matgomes21/percepcao-termica/Hardware/PCB/CONTROLLER_02.png

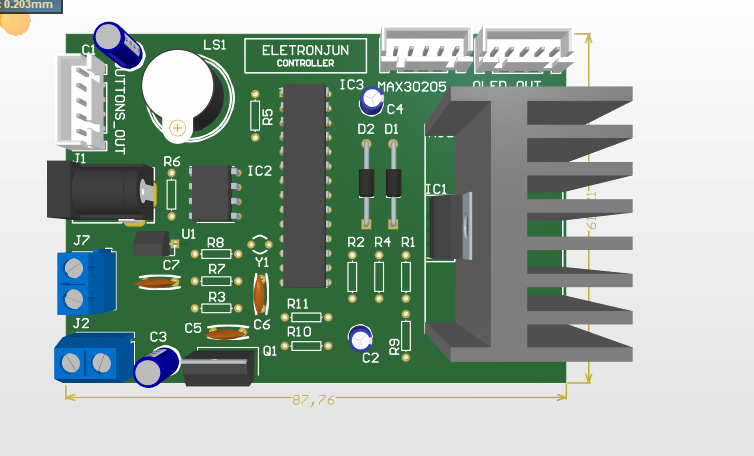
Hardware/PCB/CONTROLLER_02.png
