matgomes21/percepcao-termica/README.md

# Percepção Térmica

Projeto desenvolvido pela equipe Eletronjun, consiste na construção de um sistema de controle e coleta de temperatura corporal para monitoramento médico da sensibilidade epitelial.
