matgomes21/percepcao-termica/Documentation/Relatório_Técnico_Final.pdf

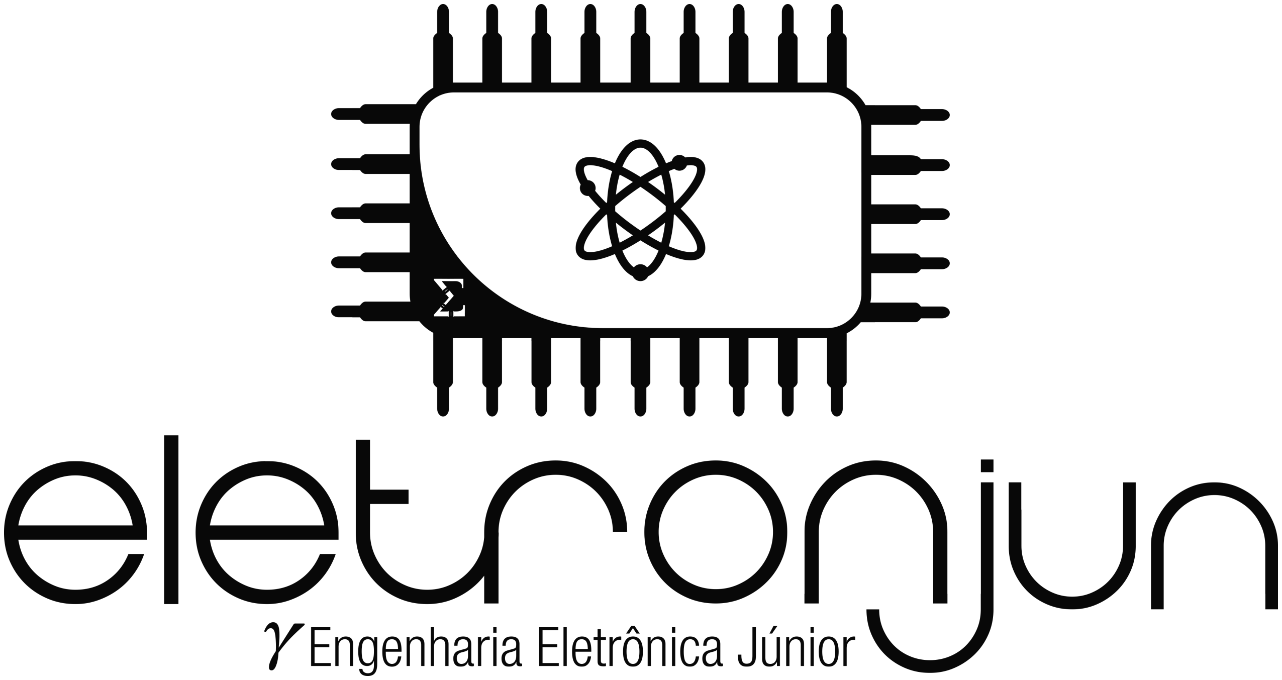
[picture p2: figure]

Percepçao T ˜ | ermica ´
Membros responsaveis: ´ | Amanda Henriques, Bruna Medeiros, Gustavo Linhares,
| Mateus Gomes, Matheus Gois, Natalia Ferreira e Vitor Guedes ´
Data de Início: | [21/10/2019]
Data de Entrega: | [22/08/2020]

2 HARDWARE

## 1 Introduçaõ

O projeto Percepçao t ˜ | ermica consiste na construç ´ | ao de um sistema de controle e ˜
coleta de temperatura corporal para monitoramento medico da sensibilidade epitelial. ´

Com os quatro subsistemas que constituem o projeto (controle e leitura de tem-
peratura, alimentaçao, interface gr ˜ | afica), o prot ´ | otipo ser ´ | a capaz de aumentar a tem- ´
peratura na pele enquanto a monitora. Ao atingir uma temperatura ”quente”, ou seja,
temperatura na qual o paciente sente essa sensaçao, o bot ˜ | aõ e apertado e os valores ´
sao armazenados e expostos no display. Dessa forma, o profissional de sa ˜ | ude ser ´ | á
capaz de avaliar a situaçao do usu ˜ | ario de forma eficiente. ´

Este documento tem como objetivo listar todos os componentes relacionados ao hardware, software e modelagem do sistema para o desenvolvimento do projeto, bem
como sua integraçao e funcionamento. Finalizando, assim, a fase de prototipaç ˜ | aõ
transcorrida ate aqui. ´

## 2 Hardware

### 2.1 Sensor MAX30205

O sensor de temperatura MAX30205 mede com precisao temperatura e fornece ˜ um alarme de superaquecimento / saída de interrupçao / desligamento. Este disposi- ˜ tivo converte as mediçoes de temperatura para o formato digital usando um conversor ˜
analogico-digital (ADC) de alta resoluç ´ | ao, sigma-delta. ˜
A precisao atende ˜ | as especificaç ` | oes cl ˜ | ínicas de termometria de o ASTM E1112
quando soldado na PCB final. Neste projeto, o mesmo sera aplicado na palma da ´
mao, antebraço, peito p ˜ | e e coxa. ´

ELETRONJUN – UNIVERSIDADE DE BRASÍLIA
EMPRESA JUNIOR DE ENGENHARIA ELETR ´ | ONICA ˆ
Area Especial de Ind ´ | ustria ´ | − Projeçao A ˜ | | 72444-240 | Gama/DF
www.eletronjun.com.br | contato@eletronjun.com.br

2.1.1 Especificaçoes T ˜ | ecnicas ´
Tensao de operaç ˜ | aõ | 2,7 a 3,3 V
Corrente de operaçaõ | 600µA
Tipo de comunicaçaõ | I2C
Precisaõ | | 0.1 ◦C

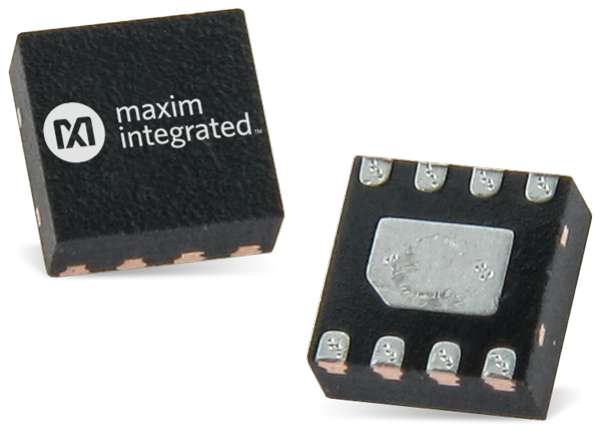
[picture p3: figure]

### 2.2 OLED

O Display OLED com tela de 0,96 conta com tecnologia que o possibilita ter uma
iluminaçao pr ˜ | opria, n ´ | ao sendo necess ˜ | aria a utilizaç ´ | ao de ˜ | backlight, intensificando o
contraste no conteudo exibido e consecutivamente apresentando maior economia de ´ energia.
Por ja estar integrado em um m ´ | odulo e possuir comunicaç ´ | ao I2C, o Display OLED ˜
e ideal para aplicaç ´ | ao em projetos de prototipagem baseados em microcontroladores, ˜
entre eles, o Arduino, possuindo pinagem fixa para alimentaçao e entrada de dados ˜ I2C.
2.2.1 Especificaçoes T ˜ | ecnicas ´
Tensao de operaç ˜ | aõ | 3,3 a 5V
Corrente de operaçaõ | 24mA
Tipo de comunicaçaõ | I2C
Preço Unitario ´ | | R$ 33,90

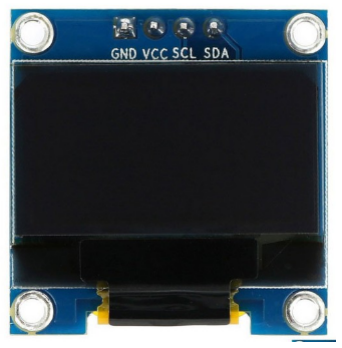
[picture p4: figure]

### 2.3 LED RGB

O LED (light-emitting diode) RGB, como o proprio nome indica, ´ | e um led capaz ´
de gerar 3 cores: vermelho ((R) red), verde ((G) green) e azul ((B) blue). Esse com-
ponente se torna muito util quando precisamos de uma indicaç ´ | ao visual do que est ˜ | á
acontecendo com o nosso sistema. Alem dessas 3 cores, ligando 2 ou 3 delas si- ´ multaneamente, podemos gerar as cores de sua combinaçao, aumentando assim o ˜

numero de possibilidades que podemos representar. ´

2.3.1 Especificaçoes T ˜ | ecnicas ´
Tensoes de operaç ˜ | aõ

2.0 V (Vermelho)
3.4 V (Verde)
3.4 V (Azul)
Corrente de operaçaõ | 20mA
Preço Unitario ´ | R$ 0,95

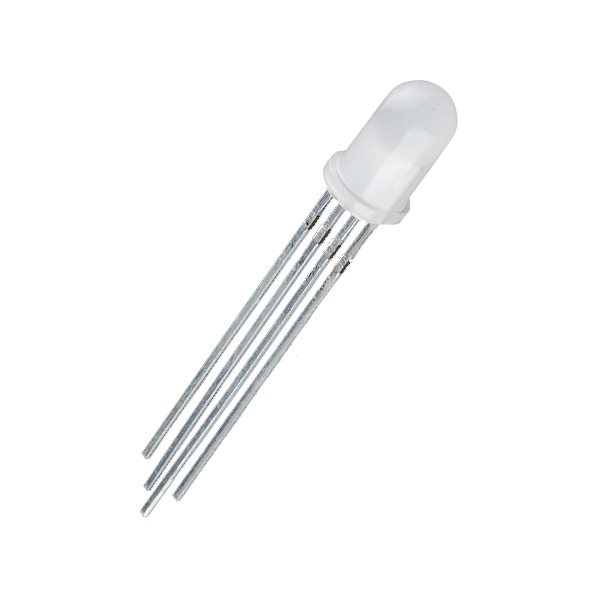
[picture p5: figure]

### 2.4 Botoes ˜

Os botoes s ˜ | ao componentes simples, por ˜ | em muito bem utilizados em diversas ´
aplicaçoes do nosso dia-a-dia: usando um controle remoto, acessando sites pela in- ˜ ternet, utilizando um micro-ondas etc. Esse pequeno componente possui um princípio bem simples de funcionamento, permitindo ou nao a passagem de corrente. Com ˜
isso, quando apertamos ou soltamos um botao, fazemos com que alguma operaç ˜ | aõ
dentro do sistema ocorra, gerando assim o resultado que desejamos.

### 2.4.1 Especificaçoes T ˜ ecnicas ´

Chave Tactil ´

Tensao de operaç ˜ | aõ | XX
Corrente de operaçaõ | 50mA
Preço Unitario ´ | | R$ 0,15

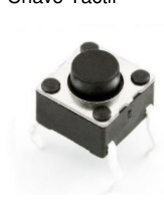
[picture p6: figure]
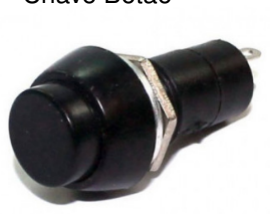
[picture p7: figure]

Chave Botaõ

Tensao de operaç ˜ | aõ | XX
Corrente de operaçaõ | 3A - 250VCA
Preço Unitario ´ | | R$ 1,80

### 2.5 Potenciometro Digital X9C104

Um potenciometro ˆ | e um componente capaz de variar sua resist ´ | encia. O mais ˆ
comumente usado e o potenci ´ | ometro anal ˆ | ogico, no qual possu ´ | ímos um eixo que,
quando girado, gera um aumento ou uma reduçao da resist ˜ | encia resultante. No caso ˆ
do projeto, esta sendo utilizado um potenci ´ | | ometro digital, ou seja, ao inv ˆ | es de girar- ´
mos o eixo do componente, nos conectamos os terminais do mesmo em um micro- ´ controlador e, utilizando suas portas de entrada e saída e um pouco de programaçao, ˜
nos controlamos essa resist ´ | encia sem precisar fazer qualquer alteraç ˆ | ao no circuito. ˜
Tensao de operaç ˜ | aõ | 5V
Corrente de operaçaõ | 3mA
Resistencia M ˆ | axima: ´ | 100 KΩ
Preço Unitario ´ | | $6.35

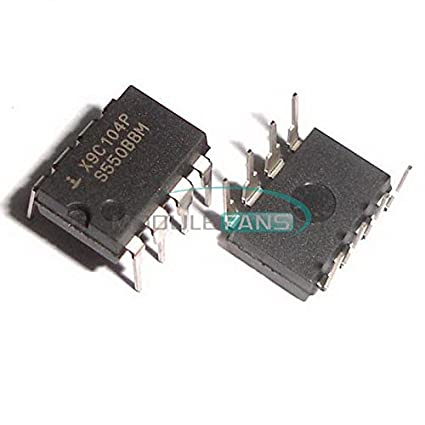
[picture p8: figure]

### 2.6 Reguladores

Um regulador de tensaõ e um componente capaz de realizar a manutenç ´ | ao da ˜
tensao de sa ˜ | ída de um circuito. Geralmente ele e utilizado na entrada de circuitos, ´
dentro de um sistema de controle de alimentaçao, com o objetivo principal de limi- ˜
tar sua tensao que passa por ele, evitando assim que passem tens ˜ | oes muito altas, ˜
capazes de danificar ou inutilizar um componente e/ou um circuito inteiro. Sendo as-
sim, sua utilidade esta intimamente atrelada ´ | a faixa de tens ` | ao em que ele consegue ˜
operar.

### 2.6.1 LM317

Maxima diferença entre ´
tensao de entrada e sa ˜ | ída

40V

Tensao de sa ˜ | ída | 1,2V a 37V
Corrente de saída | 1,5A
Preço Unitario ´ | | R$1,42

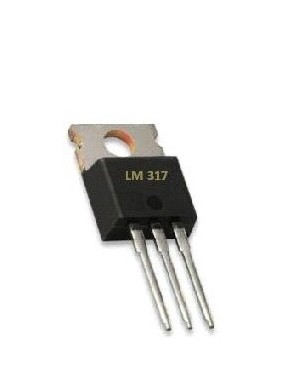
[picture p9: figure]

### 2.6.2 LM7805

Mínima diferença entre
tensao de entrada e sa ˜ | ída | 2,4V
Tensao de entrada ˜ | | 7,4 a 28V
Tensao de sa ˜ | ída | 5V
Corrente maxima de sa ´ | ída | 1,5A
Preço Unitario ´ | | R$0,99

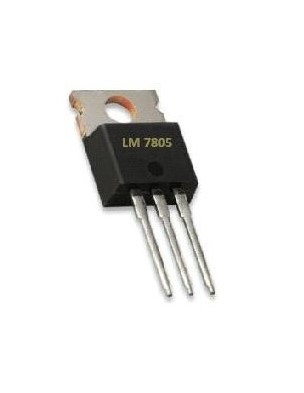
[picture p10: figure]

### 2.7 Peltier

O Peltier e uma pastilha termoel ´ | etrica que, atrav ´ | es de alimentaç ´ | ao controlada e ˜
adequada, possui a capacidade de aquecer e resfriar sua superfície em questao de ˜ alguns segundos ou minutos, a depender da alimentaçao. ˜
Ao colocar tensao nos terminais do Peltier, um lado ir ˜ | a aquecer rapidamente, en- ´
quanto o outro resfriara. Ao inverter a polaridade de ligaç ´ | ao, a Pastilha ir ˜ | a efetuar ´
o processo contrario, entrando em estado de aquecimento. Desse modo, torna-se ´ possível uma vasta aplicaçao em projetos com arduino e microcontroladores no ge- ˜ ral, como por exemplo: Coolers de CPU, mini-refrigeradores ou bebedouros e até aquecedores de agua. ´

Nome tecnico ´ | | TEC1-12709
Faixa de temperatura | -30 a 70o C
Tensao de operaç ˜ | aõ | 0 a 15V
Preço Unitario ´ | | R$29,90

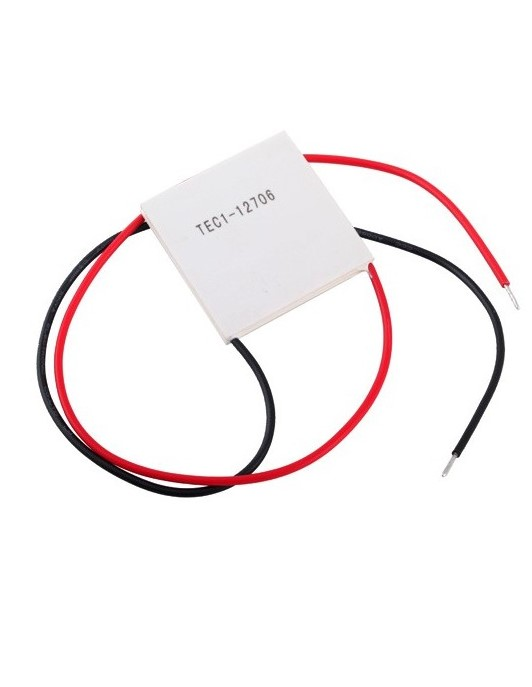
[picture p11: figure]

### 2.8 ATMega328P

O ATMega328P e um microprocessador extremamente comum em projetos eletr ´ | onicos. ˆ
Ele faz parte da família de microprocessadores ATMega, que e amplamente utilizada ´
em diversos microcontroladores do Arduino, que e muito conhecido para aplicaç ´ | oes ˜
simples e praticas dentro da eletr ´ | onica. O ATMega328P, em espec ˜ | ífico, e utilizado no ´
Arduino Uno R3, que e o modelo ”padr ´ | ao”da marca. Com ele temos portas dedicadas ˜
a comunicaçao I2C e UART, portas de entrada e sa ˜ | ída analogica e digital, possibi- ´
lidade de comunicaçaõ OneWire, comunicaçao com cart ˜ | ao SD, clock de 16MHz e ˜
muito mais.
Memoria ´ | | 32Kb
Resoluçao do conversor AD/DA ˜ | | 10 Bits
Tensao de Operaç ˜ | aõ | 1.8V a 5.5V
Preço Unitario ´ | | R$20,66

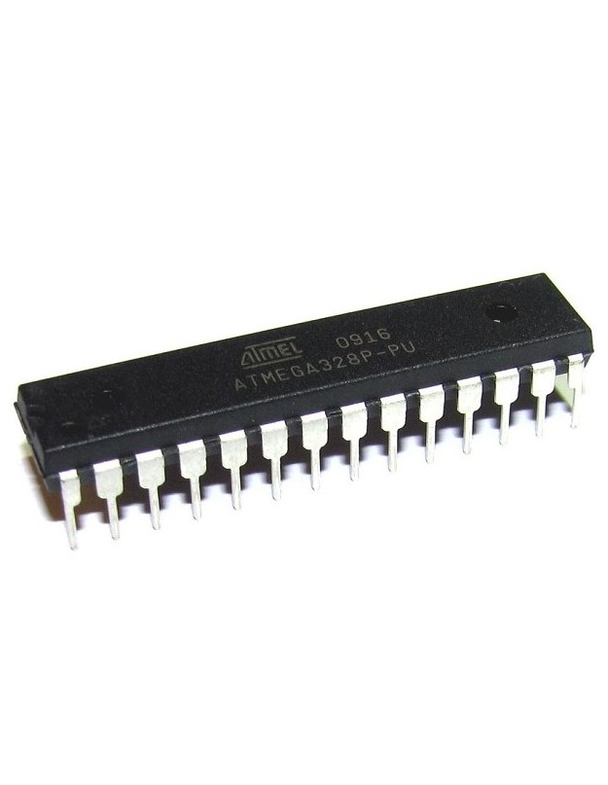
[picture p12: figure]

### 2.9 Buzzer

O Buzzer e um componente capaz de gerar um sinal sonoro. Seu ”volume”depende ´
da tensao em que opera. Alguns tipos de buzzer tamb ˜ | em possuem a ferramenta de ´
alteraçao de frequ ˜ | encia, possibilitando o ajuste dessa caracter ˆ | ísticas para a produçaõ
de musicas ou bips simples como aqueles de alarmes de carro, por exemplo. ´

Tensao de operaç ˜ | aõ | 5V
Corrente maxima ´ | | 42mA
Intensidade de saída | ≥ 85dB
Preço Unitario ´ | | R$1,52

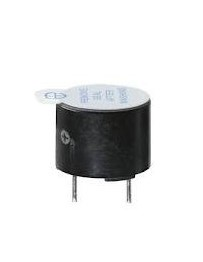
[picture p13: figure]

### 2.10 Mosfet IRF540n

Um transistor MOSFET(Metal Oxide Semiconductor Field Effect Transistor) e um ´ componente de 3 terminais que possui diversas aplicaçoes dentro do mundo de cir- ˜
cuitos eletronicos e afins. Um uso comum para esse tipo de componente ˆ | e utiliz ´ | a-lo ´
como uma chave, fazendo-o ”desligar”em alguma situaçao espec ˜ | ífica. No nosso caso,
nos utilizamos essa funcionalidade para evitar gastos desnecess ´ | arios com n ´ | íveis de
tensao e corrente muitos baixos, que n ˜ | ao chegam nem a fazer nosso sistema funcio- ˜
nar totalmente. Com isso, e poss ´ | ível evitar o aquecimento dos componentes e gastos
de energia desnecessarios. ´

Corrente maxima no dreno (a 25 ´

oC) | 33 A
Dissipaçao m ˜ | axima de pot ´ | encia ˆ | 130W
VGS maximo ´ | | | ± 20V
Preço Unitario ´ | | | R$3,23

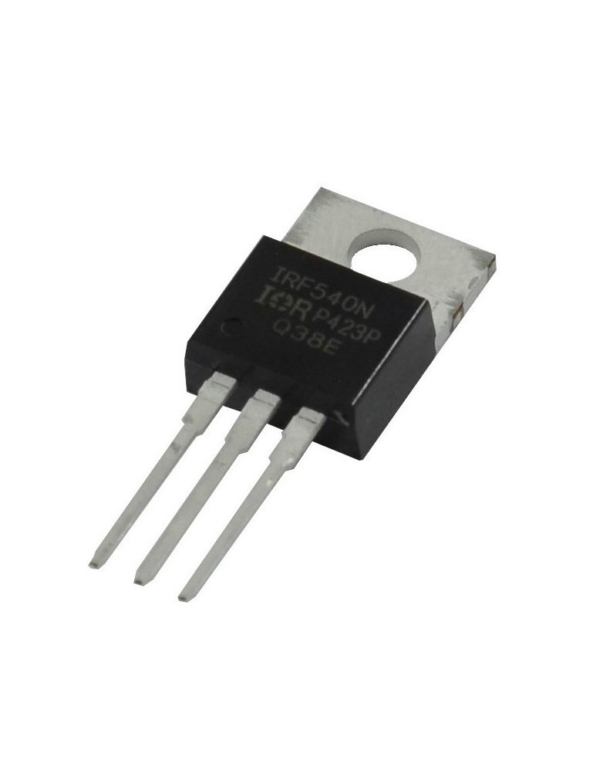
[picture p14: figure]

### 2.11 Integraçaõ

A etapa de integraçao do projeto ˜ | e onde juntamos todos os m ´ | odulos, componen- ´
tes, CIs (circuitos integrados) e tudo que compoe o circuito e o sistema do projeto no ˜
geral. O objetivo final dessa integraçaõ e fazer com que todos os m ´ | odulos do projeto, ´
que foram previamente testados e tidos como funcionais, continuem funcionando corretamente, sem qualquer tipo de defeito ou erro inesperado causado pela uniao do ˜ sistema.

### 2.11.1 Esquematico ´

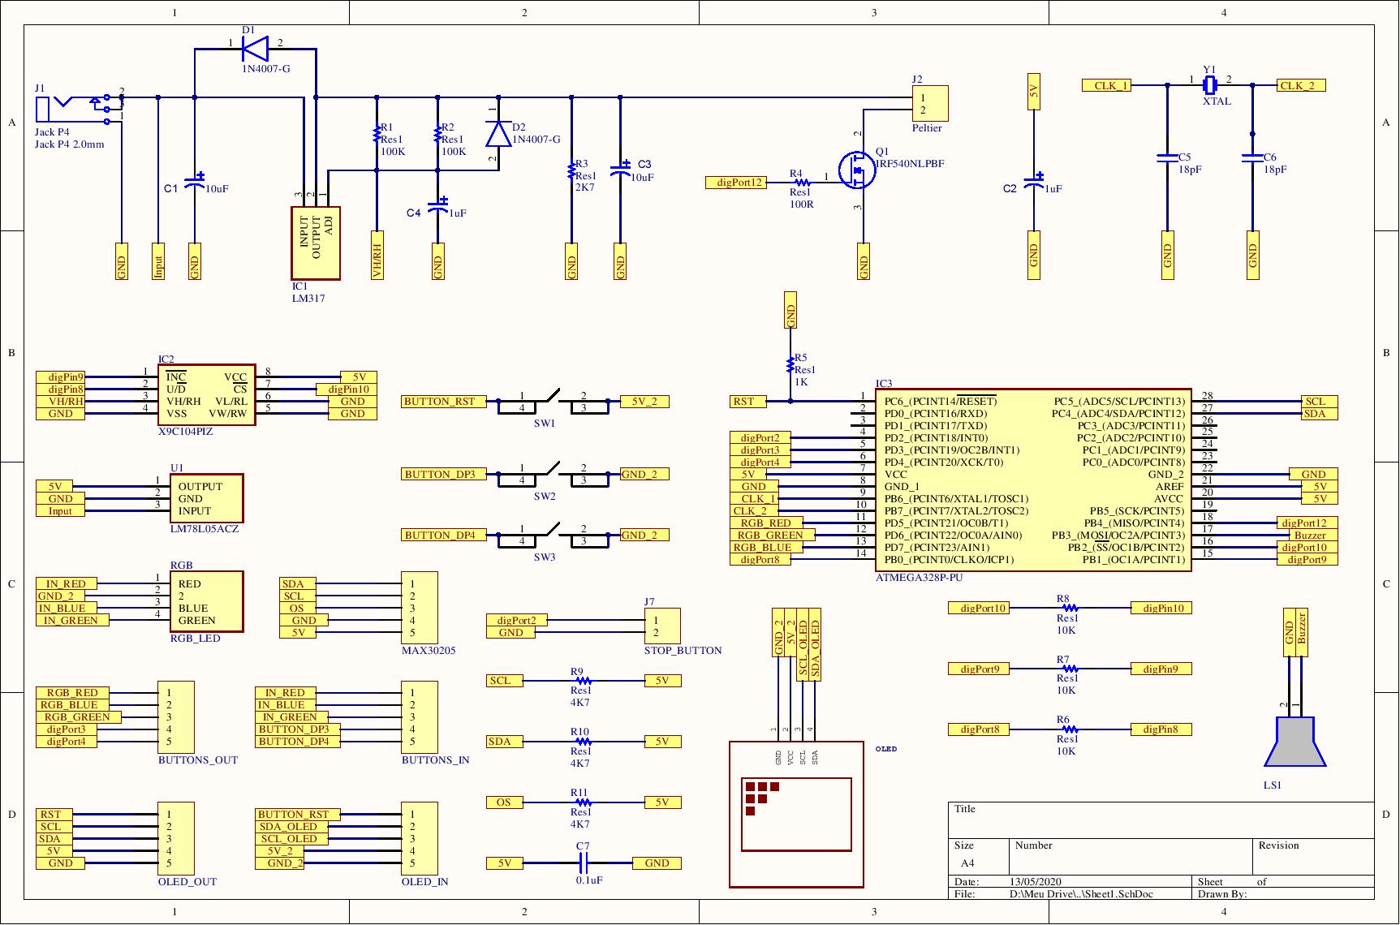
[picture p15: figure]

### 2.11.2 Layout PCI

PCI (placa de circuito impresso) ou, do ingles, PCB ( ˆ | Printed Circuit Board) e a ´
placa física em que contruímos nosso circuito. Utilizando o esquematico como um ´ guia de como devemos ligar cada componente, realizamos o processo de layout (”desenho”da PCI, realizado por meio de softwares no computador); de fabricaçao, onde ˜
sao feitas as trilhas e os furos do circuito, onde ser ˜ | ao colocados os componentes du- ˜
rante a etapa de soldagem. Com isso, temos uma PCB/PCI completa e pronta para uso.

Placa de Interface Nesse placa estao presentes todos os componentes com os ˜
quais o usuario do sistema dever ´ | a interagir ou que dever ´ | ao ser vistos por ele para ˜
indicar algo sobre o circuito: LEDs (o LED RGB, no caso), OLED e botoes. ˜

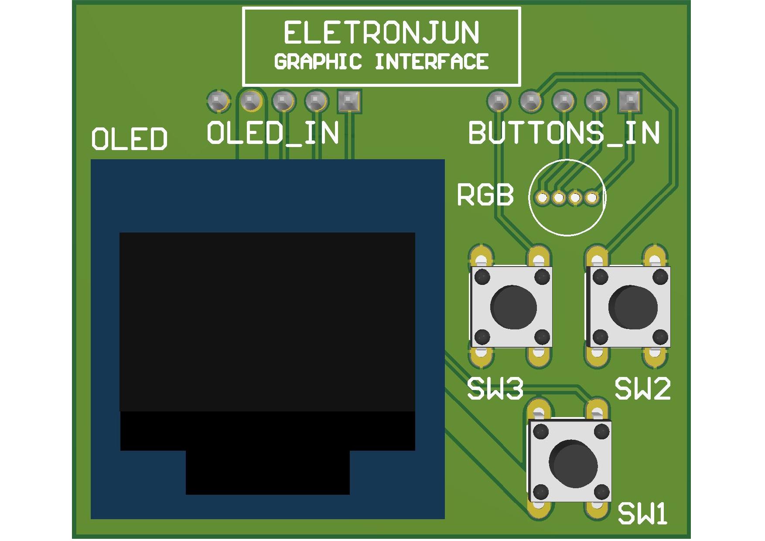
[picture p16: figure]

Placa de Controle Na placa de controle se encontram todos os demais componen-
tes do circuito: aqueles responsaveis pelo circuito de alimentaç ´ | ao, pelo circuito de ˜
controle de tensao e corrente, pela interface com software e outros. Nessa placa se ˜
encontra presente tambem o dissipador ( ´ | heatsink na imagem), que e utilizado para ´
reduzir a temperatura do LM317, que pode chegar a temperaturas de ate 125 ´

o C.

Alem disso, o ´ | buzzer, responsavel pelos avisos sonoros dentro do sistema, tamb ´ | em´
esta na placa de controle. Visto que o mesmo n ´ | ao necessita ser visto pelo usu ˜ | ario ´
para que funcione e que sua potencia sonora ˆ | e capaz de ser ouvida mesmo quando ´
isolado, nao foi necess ˜ | ario coloc ´ | a-lo na placa de interface gr ´ | afica. ´

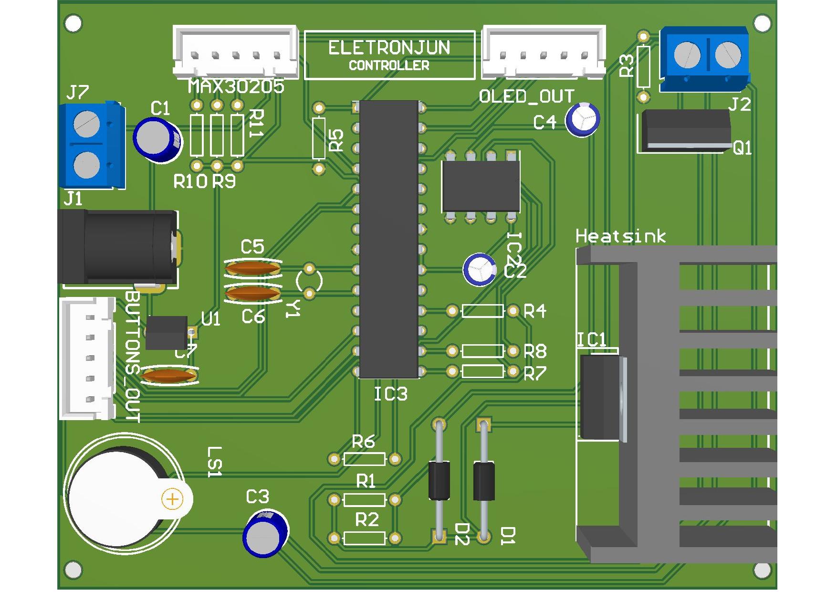
[picture p17: figure]

3 SOFTWARE

## 3 Software

### 3.1 Orientaçao a Objetos ˜

No projeto, o software foi orientado a objetos, visto que e um t ´ ecnica que visa o ´ reaproveitamento do software caso um subsistema futuramente precisar de upgrades.
Alem disso o c ´ | odigo tem caracter ´ | ísticas de responsividade e consistencia. ˆ

Somando a isso, foram criadas classes, no desenvolvimento de firmware, classes nesse contexto sao chamadas de bibliotecas, nas quais controlam o X9C104, LED ˜ RGB, Buzzer, OLED e MAX30205.

### 3.2 Coleta de Dados

| A coleta de informaçoes medidas pelo sensor de temperatura ˜ | e feita a partir da ´
biblioteca ”Protocentral MAX30205”. Usando o metodo ”getTemperature()”da classe ´
MAX30205, e poss ´ | | ível pegar o valor da temperatura atual lida pelo sensor e arma-
zena-lo em uma vari ´ | avel. ´
| Exemplo de aplicaçao da coleta abaixo: ˜
1 | MAX30205 tempSensor ; // instanciamento do objeto tempsensor da
| classe MAX30205
2 | float temperature_coletada ; // declaracao da variavel para coletar
| a temperatura
3 | temperatura_coletada = tempSensor . getTemperature () ; // armazena
| valor da temperatura ( lida pelo sensor ) na variavel ’
| temperatura_coletada ’

### 3.3 Controle de Perifericos ´

O controle de perifericos ´ | e feito por meio de classes, sendo que cada perif ´ | erico ´
possui uma classe com seus metodos e atributos. ´

3 SOFTWARE

### 3.3.1 Buzzer

A classe do Buzzer possui um atributo privado para armazenar o pino que o
mesmo esta conectado ao arduino, um m ´ | etodo construtor e um m ´ | etodo para ativar ´
seu som por um período específico.
E poss ´ | ível ver a declaraçao da classe no c ˜ | odigo abaixo: ´
1 | class Buzzer
2 | {
3 | private :
4 | int _pin ; // atributo privado que armazena o pino
5 | public :
6 | Buzzer ( int pin ) ; // metodo construtor que inicializa o buzzer
| com o pino certo
7 | void beep (int temp ) ; // metodo para ativar o som do buzzer
| durante o periodo dado por " temp "
8 | };

### 3.3.2 LED RGB

A classe do LED RGB possui tres atributos privados para armazenar os pinos das ˆ
cores verde, vermelho e azul, um metodo construtor e um m ´ | etodo que acende uma ´
cor específica.
E poss ´ | ível ver esta classe no codigo abaixo: ´
1 | class LedRGB
2 | {
3 | private :
4 | int green ; // pino verde
5 | int blue ; // pino azul
6 | int red ; // pino vermelho
7 | public :
8 | LedRGB ( int p1 , int p2 , int p3 ) ; // metodo construtor que
| inicializa o led com os pinos certos
9 | void turnOn ( char colour ) ; // metodo que acende o LED com a cor
| armazenada na variavel ’colour ’
10 | };

3 SOFTWARE

### 3.3.3 Botoes ˜

A classe dos Botoes possui um atributo privado para armazenar o pino do bot ˜ | aõ
que esta sendo instanciado, dois atributos p ´ | ublicos para armazenar a situaç ´ | ao atual ˜
do botao (se est ˜ | a pressionado ou n ´ | ao), um m ˜ | etodo construtor e um m ´ | etodo para ´
interromper o botao. ˜
E poss ´ | ível ver a declaraçao da classe no c ˜ | odigo abaixo: ´
1 | class PushButton
2 | {
3 | private :
4 | int _pin ; // variavel para armazenar pino

5
6 | public :
7 | PushButton (int pin ) ; // construtor que inicializa o botao com
| seu pino
8 | boolean pressed ( void ) ; // atributo para saber o estado do
| botao ao ser pressionado
9 | boolean isPressed ( void ) ; // atributo para saber o estado do
| botao ao ser interrompido
10 | void interrupt ( void ) ; // metodo para definir o pino de
| interrupcao
11 | };

### 3.4 OLED

O display OLED e controlado a partir da biblioteca ”U8glib”, que possui funç ´ | oes ˜
que permitem escrever e mostrar valores na tela do display. As telas desenhadas apos´
a etapa de prototipaçao sofreram pequenas mudanças em comparaç ˜ | ao ao projeto ˜
conceitual, porem, atendem as especificaç ´ | oes feitas no documento de requisitos. ˜

### 3.4.1 Layout

Aqui serao exibidas as telas conceituais apresentadas no relat ˜ | orio de requisitos, ´
juntamente com as telas reais.
- Menu Inicial

3 SOFTWARE

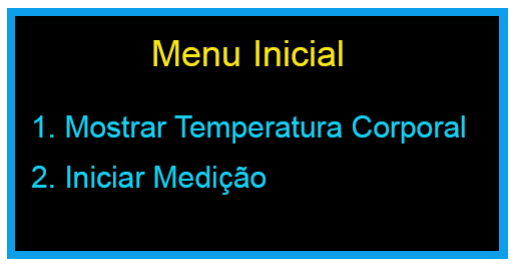
[picture p18: figure]

- Tela da Temperatura Corporal

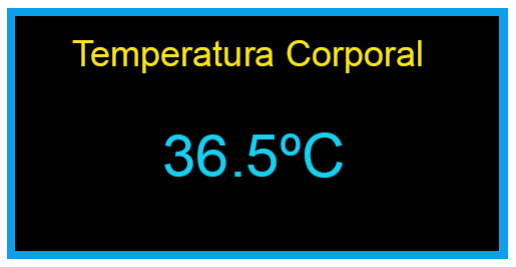
[picture p19: figure]

- Tela do Teste

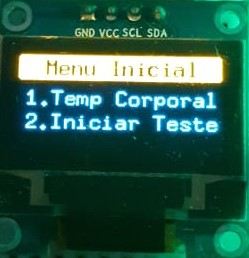
[picture p20: figure]
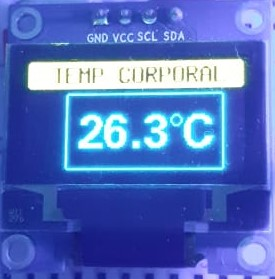
[picture p21: figure]
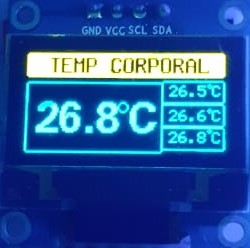
[picture p22: figure]
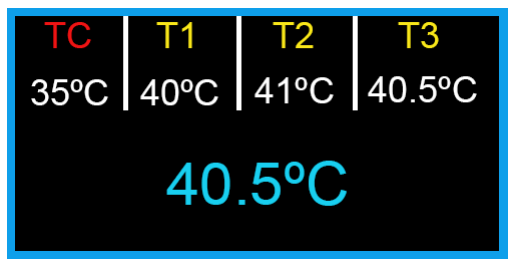
[picture p23: figure]

3 SOFTWARE

### 3.4.2 Codigo de Controle ´

A partir das funçoes da biblioteca ”U8glib”, ˜ | e poss ´ | ível desenhar cada tela de
acordo com as específicaçoes necess ˜ | arias. Exemplo da montagem de uma tela do ´
sistema:
1 | u8g . setFont ( u8g_font_8x13B ) ; // determina a fonte que sera
| usada
2 | u8g . drawRBox (0 , 0 , 127 , 16 , 2) ; // desenha uma caixa na parte
| superior da tela
3 | u8g . setColorIndex (0) ; // determina a cor dos elementos
4 | u8g . drawStr (17 , 13 , " Menu Inicial ") ; // escreve " Menu Inicial "
| na tela

### 3.4.3 Controle de Telas

Para o controle de telas, foi feita uma struct de funçoes, em que cada funç ˜ | ao re- ˜
presenta uma tela do sistema. No codigo abaixo, ´ | e poss ´ | ível ver as principais partes
do codigo de controle de telas: ´
1 | // Struct com as funcoes das telas
2 | typedef struct oled
3 | {
4 | void menuInit () // tela do menu inicial
5 | {
6 | ...
7 | }

8
9 | void menuTC () // tela da temperatura corporal atual
10 | {
11 | ...
12 | }

13
14 | void menuTest () // tela dos testes
15 | {
16 | ...
17 | }
18 | }

3 SOFTWARE

### 3.5 Controle do Peltier

O controle do peltier esta diretamente ligado ao controle do potenciometro digi- ´
tal X9C104, para entender seu funcionamento e necess ´ | ario explicar o controle do ´
X9C104.

### 3.5.1 X9C104

Para o controle do X9C104 foi elaborado a classe ”x9c104”que implementa metodos ´
que tem como funçao, habilitar, definir pinos de conex ˜ | ao com o microcontrolador, ˜
parametrizar resistencia inicial e final e controlar a velocidade da mudança da re- ˆ sistencia. ˆ
1 | class x9c10x {
2 | public :
3 | x9c10x ( int cs , int inc , int ud ) ; | // Define CS , INC and

U/D

4 | void set (int init , int lt ) ; | // Init = initial
resistance | lt = limit resistance
5 | void up (int ohms , int temp ) ; | // Speed of Ohms / Temp

UP

6 | void down (int ohms , int temp ) ; | // Speed of Ohms / Temp

DOWN

7 | void downOnce (int ohms , int temp ) ; | // Speed of Ohms /

Temp DOWN

8 | void upOnce (int ohms , int temp ) ; | // Speed of Ohms /

Temp DOWN

9 | void stop ( void ) ; | // Define sudden stop

button

10 | void readpot (int delay_temp , String analog_pin ) ; | //

Read resistance

11 | };
Os metodos upOnce e downOnce foi utilizados no projetos, definem uma iteraç ´ | aõ
de subida ou descida da resistencia, ou seja, quando chamados, o upOnce e dow- ˆ
nOnce, aumentam e diminuem a resistencia de sa ˆ | ída do terminal VW, respectiva-
mente.

4 INTEGRAÇ AÕ

### 3.5.2 Mosfet IRF540n

O software implementado para o mosfet IRF540n, tem como funçao habilitar ou ˜ desabilitar a tensao nos terminais do peltier. ˜

1 | # define cutPeltier 12 // Definindo a palavra cutPultier como o
| inteiro 12
2 | digitalWrite ( cutPeltier , HIGH ) ; // Funcao para pertimir o peltier
| receber tensao
3 | digitalWrite ( cutPeltier , LOW ) ; // Fucao que nega ao peltier
| tensao em seus terminais

## 4 Integraçaõ

### 4.1 PCB

Fotos reais da placa:

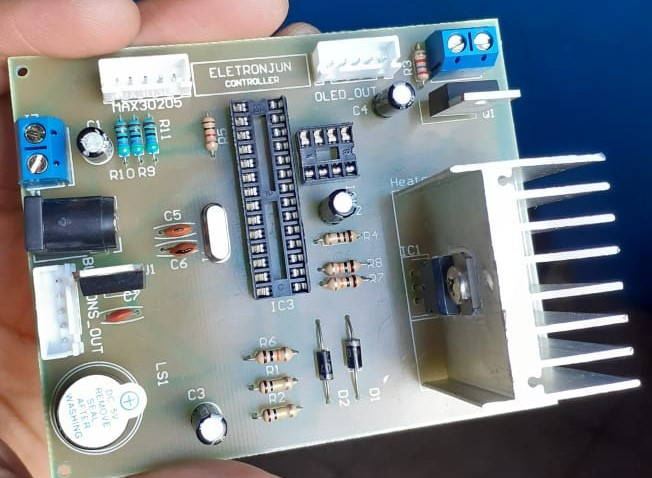
[picture p24: figure]

Figura 1: Placa Controller

4 INTEGRAÇ AÕ

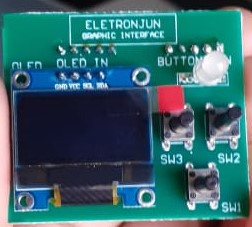
[picture p25: figure]

Figura 2: Placa Graphic Interface

### 4.2 CAD

Fotos da modelagem do CAD e reais:

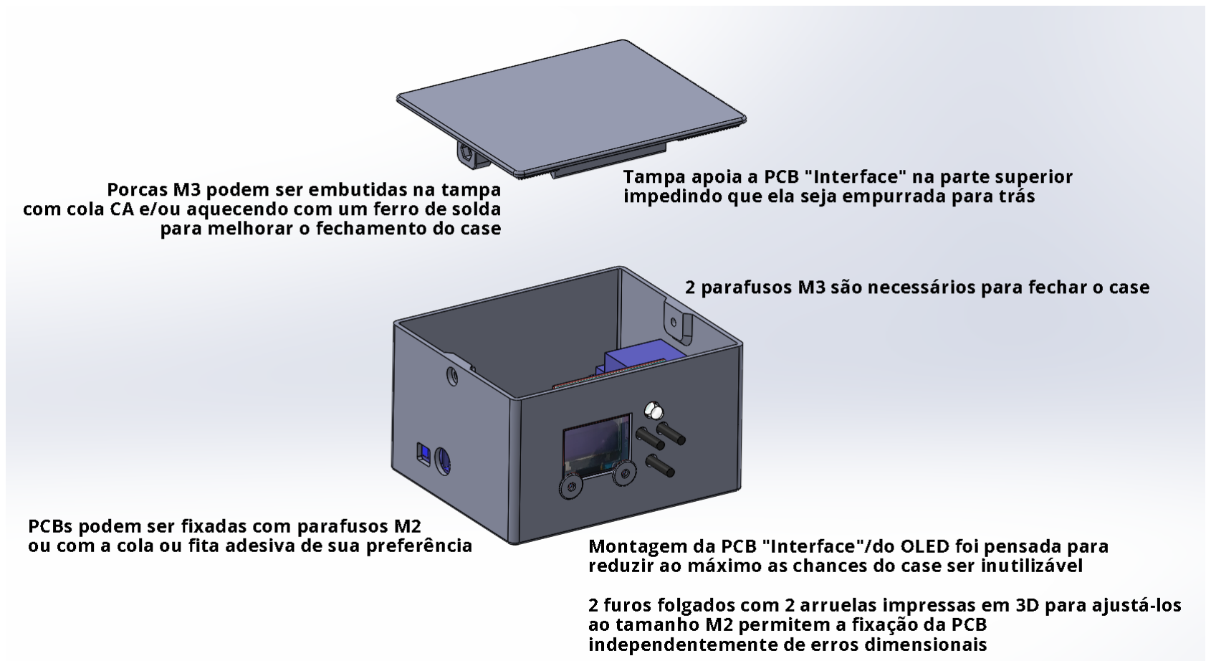
[picture p26: figure]
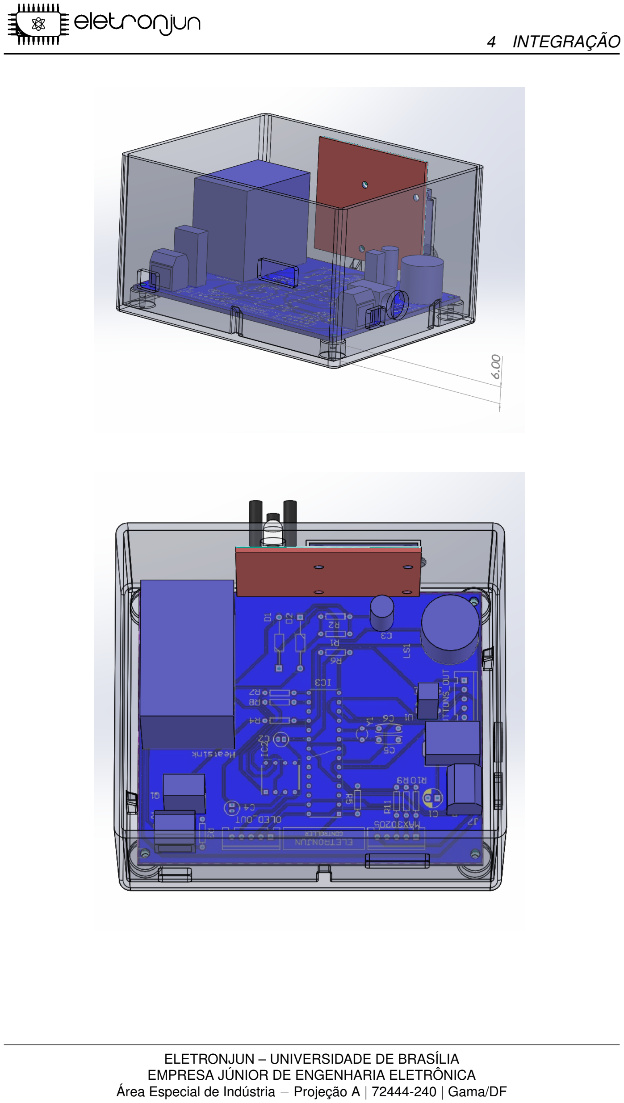
[picture p27: page 19]

4 INTEGRAÇ AÕ

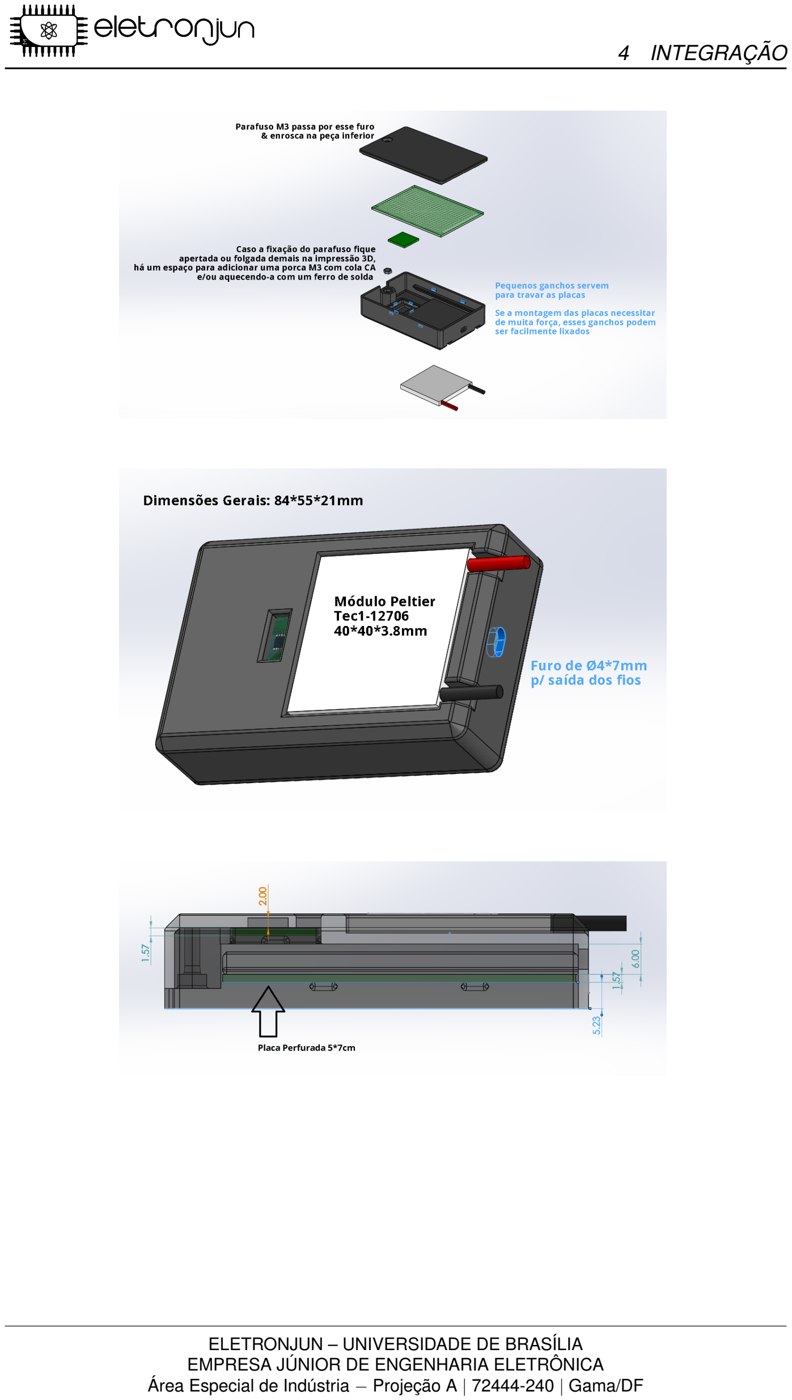
[picture p28: page 20]

4 INTEGRAÇ AÕ

4 INTEGRAÇ AÕ

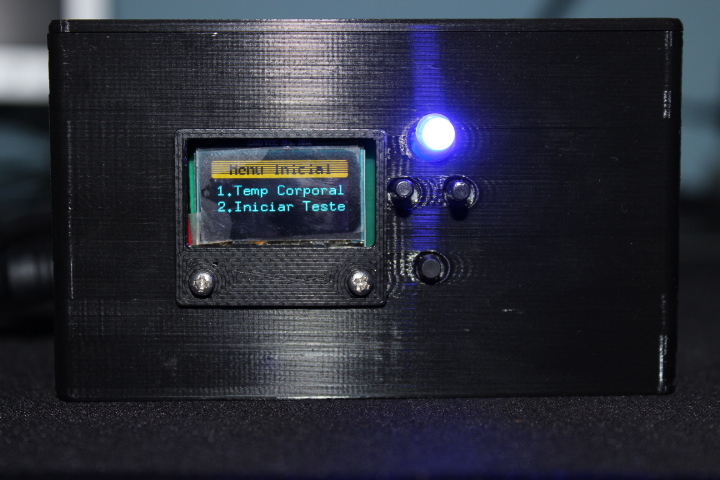
[picture p29: figure]

Figura 3: Imagem frontal da Case Controller

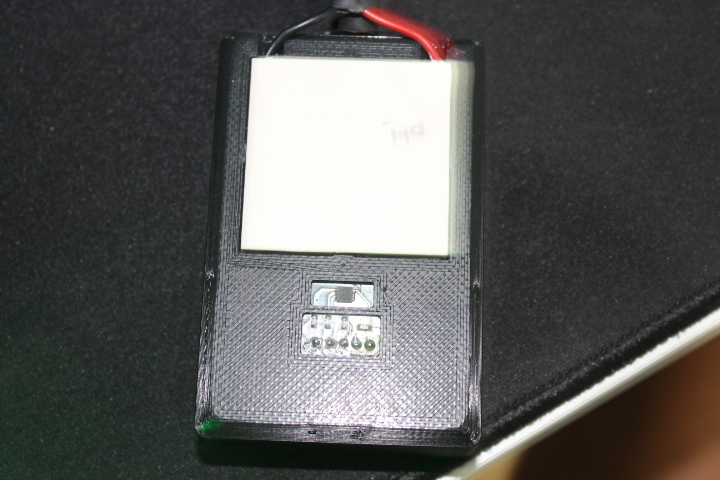
[picture p30: figure]

Figura 4: Imagem superior do aplicador

5 CONCLUSAÕ

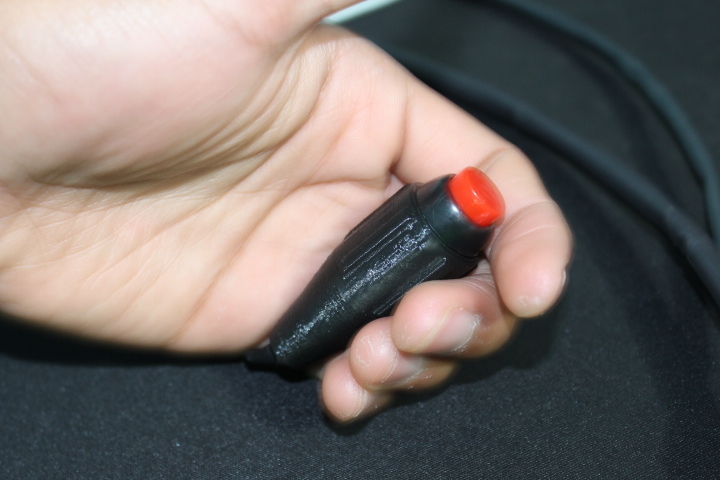
[picture p31: figure]

Figura 5: Imagem do botao para iniciar o teste ˜

## 5 Conclusaõ

O projeto Percepçao T ˜ | ermica foi finalizado com exito, todas as t ´ | ecnicas e objetivos ´
desenvolvidos no Projeto Conceitual e documento de requisitos foram atendidos, ape-
sar de sofrerem modificaçoes. A parte de controle de temperatura da c ˜ | elula de Peltier ´
que foi alterado significativamente devido a falhas no sistema apresentado na parte
conceitual, porem foi contornado com uma nova soluç ´ | ao que se apresentou bastante ˜
eficaz na fase de teste de prototipo. ´

O projeto passou por dificuldades devido a epoca da pandemia por conta do Covid- ´
19, materiais foram atrasados para chegar e a logística para a produçao do prot ˜ | otipo ´
foi complicado, com isso, o projeto nao atendeu o prazo previamente planejado, por ˜ | em´
foi finalizado.
