matgomes21/percepcao-termica/Hardware/CAD/dimensions/1.png

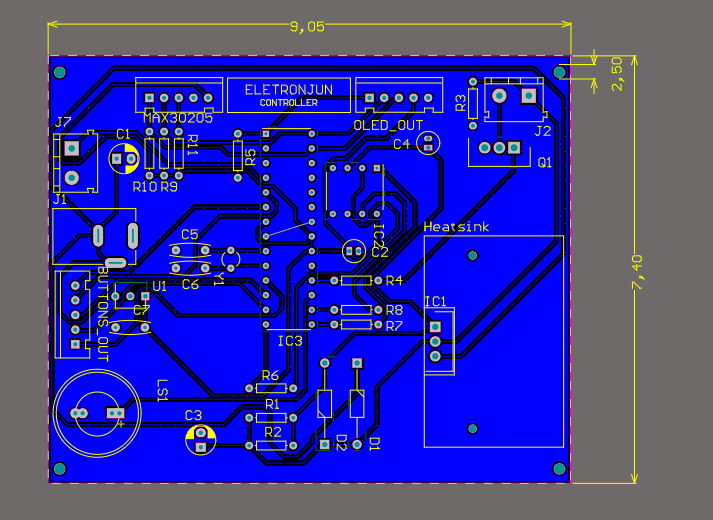
Hardware/CAD/dimensions/1.png
