matgomes21/percepcao-termica/Hardware/CAD/dimensions/2.png

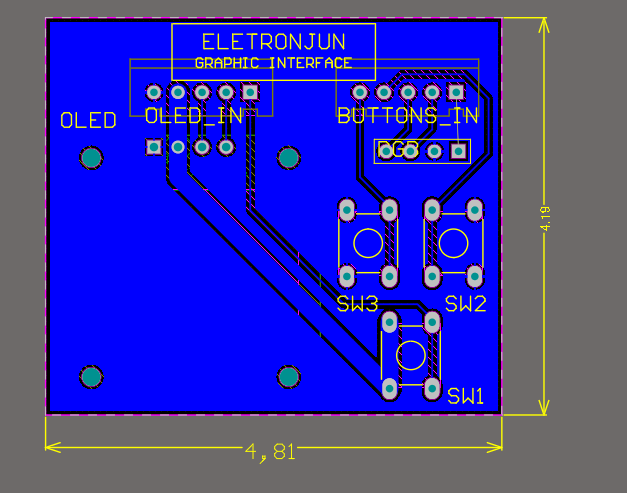
Hardware/CAD/dimensions/2.png
