matgomes21/percepcao-termica/Hardware/CAD/dimensions/3.png

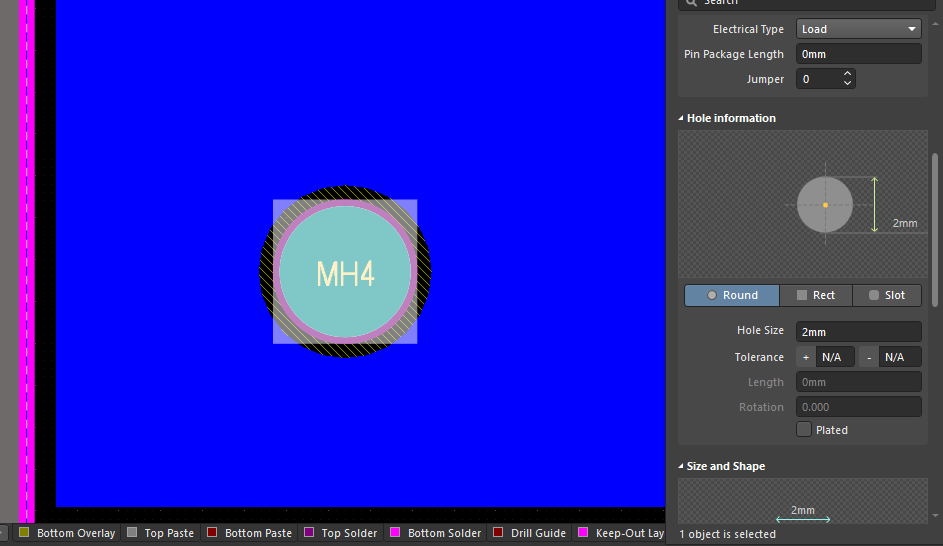
Hardware/CAD/dimensions/3.png
