matgomes21/percepcao-termica/Hardware/CAD/dimensions/4.png

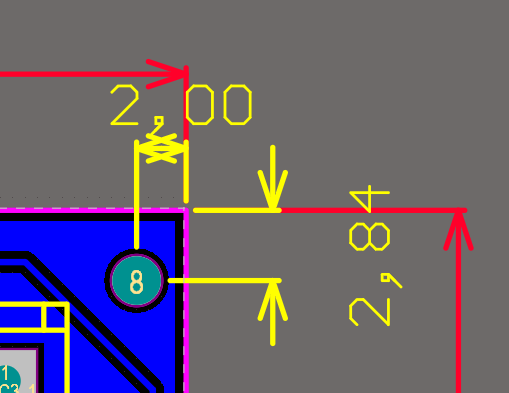
Hardware/CAD/dimensions/4.png
