matgomes21/percepcao-termica/Hardware/CAD/dimensions/5.png

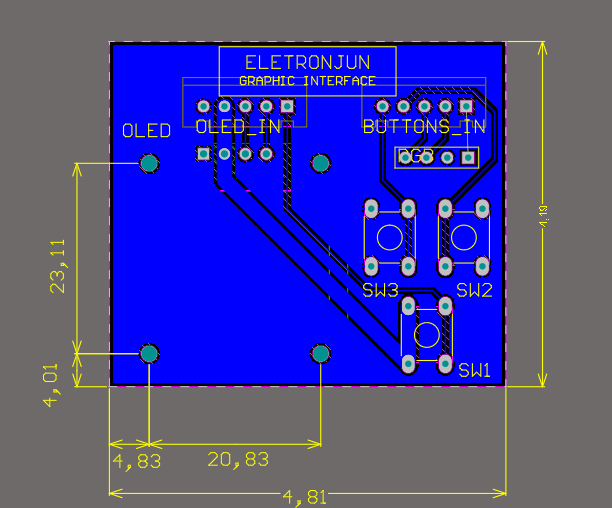
Hardware/CAD/dimensions/5.png
