matgomes21/percepcao-termica/Hardware/CAD/dimensions/6.png

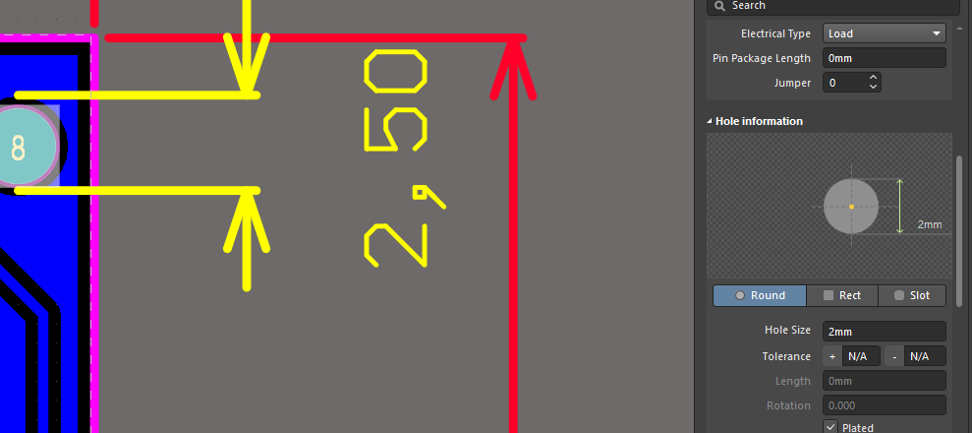
Hardware/CAD/dimensions/6.png
