matgomes21/percepcao-termica/Hardware/PCB/CONTROLLER.png

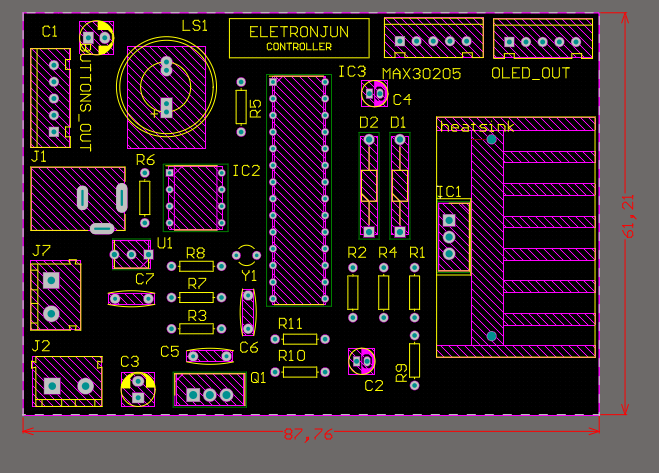
Hardware/PCB/CONTROLLER.png
