matgomes21/percepcao-termica/Hardware/PCB/GRAPHIC_INTERFACE.png

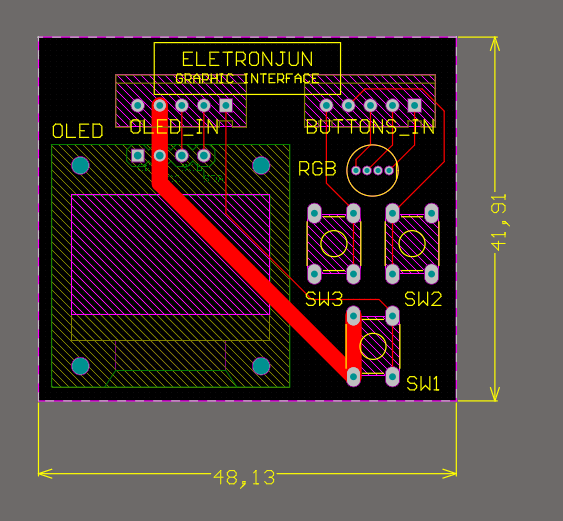
Hardware/PCB/GRAPHIC_INTERFACE.png
