matgomes21/percepcao-termica/Hardware/PCB/GRAPHIC_INTERFACE_02.png

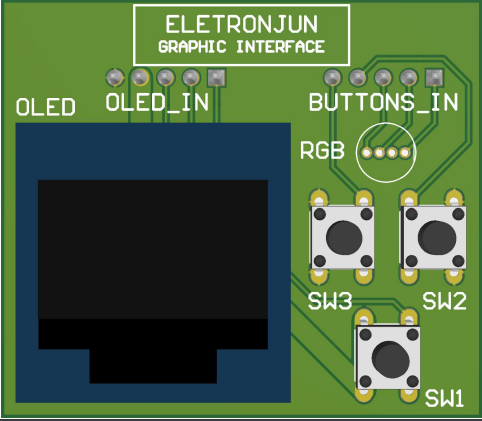
Hardware/PCB/GRAPHIC_INTERFACE_02.png
