matgomes21/percepcao-termica/Hardware/BOM/BOM_Percepção_Térmica.csv

ID | Name | Designator | Footprint | Quantity | Manufacturer Part | Manufacturer | Supplier | Supplier Part | _Price | EasyEDA | LCSC Assembly
1 | OLED Display | U9 | GROVE - OLED DISPLAY 1.12'' | 1 |  |  | SeeedStudio | undefined
2 | φ5 RGB Transparent | LED1 | LED-TH_4P-BD5.8-P1.30 | 1 | φ5 RGB Transparent LED | KENTO | LCSC | C32985
3 | IRF540N | Q1 | TO-220AB | 1
4 | jack P4 | J1 | 2.1MM POWER JACK | 1 | RAPC722X | Switchcraft | Mouser | 502-RAPC722X
5 | LM317_C22147 | U4 | TO-220-3_L10.0-W4.5-P2.54-L | 1 | LM317 | CJ | LCSC | C22147
6 | 1u | C4,C2 | CAP-D3.0XF1.5 | 2
7 | 10u | C1,C3 | CAP-D3.0XF1.5 | 2
8 | ATMEGA328P | U7 | DIP-28_300MIL | 1 | ATMEGA328P-PU | ATMEL | EasyEDA | C33901 |  | C33901
9 | X9C104SIZT1 | U2 | SOIC-8_L4.9-W3.9-P1.27-LS6.0-BL | 1 | X9C104SIZT1 | Intersil | LCSC | C11979 |  |  | Yes
10 | MAX30205 | U8 | NONE | 1
11 | 1u | 18PF | RAD-0.1 | 1
12 | 0.1u | C6 | RAD-0.1 | 1
13 | 18pF | C5 | RAD-0.1 | 1
14 | Peltier | U1 | PELTIER | 1
15 | Buzzer-5V | BZ1 | BUZZER-5V | 1 | M12G3 | YEC | ES | 0237-0021-7
16 | 100k | R6,R2 | AXIAL-0.3 | 2
17 | 222 | R13,R7,R14 | AXIAL-0.3 | 3
18 | 4.7k | R9,R10,R11 | AXIAL-0.3 | 3
19 | 2k7 | R1 | AXIAL-0.3 | 1
20 | 10k | R5,R3,R4 | AXIAL-0.3 | 3
21 | 100 | R12 | AXIAL-0.3 | 1
22 | 1k | R8 | AXIAL-0.3 | 1
23 | 1N4007RLG | D1,D2 | DO-41_BD2.4-L4.7-P8.70-D0.9-RD | 2 | 1N4007RLG | ON | LCSC | C53568
24 | 6x6x6Plastic head | KEY2,KEY1 | KEY-6.0*6.0 | 2 | 6x6x6Plastic head | ReliaPro | LCSC | C23550
25 | LM78L05ACZ | U3 | TO-92-3_L4.9-W3.7-P1.27-L | 1 | LM78L05ACZ | ON Semicon | LCSC | C112082
26 | Crystal Oscillator 16MHz | U6 | SMD CRISTAL | 1
27 | PBS-11B-MIM | SW3,SW1 | PBS11B-MIN | 2 | SKRKAHE020 | ALPS Electric | LCSC | C202388
