matgomes21/percepcao-termica/Hardware/PCB/CONTROLLER_MEASUREMENT.png

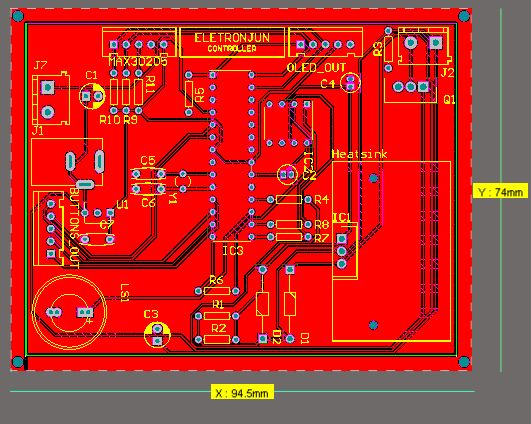
Hardware/PCB/CONTROLLER_MEASUREMENT.png
