matgomes21/percepcao-termica/Hardware/PCB/GRAPHIC_INTERFACE_MEASUREMENT.png

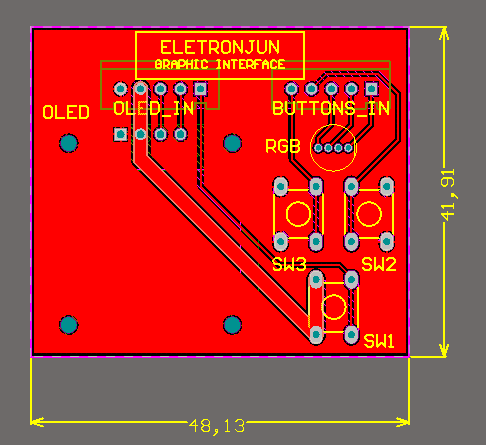
Hardware/PCB/GRAPHIC_INTERFACE_MEASUREMENT.png
