matgomes21/percepcao-termica/Hardware/BOM/PCBs +BOM.PDF

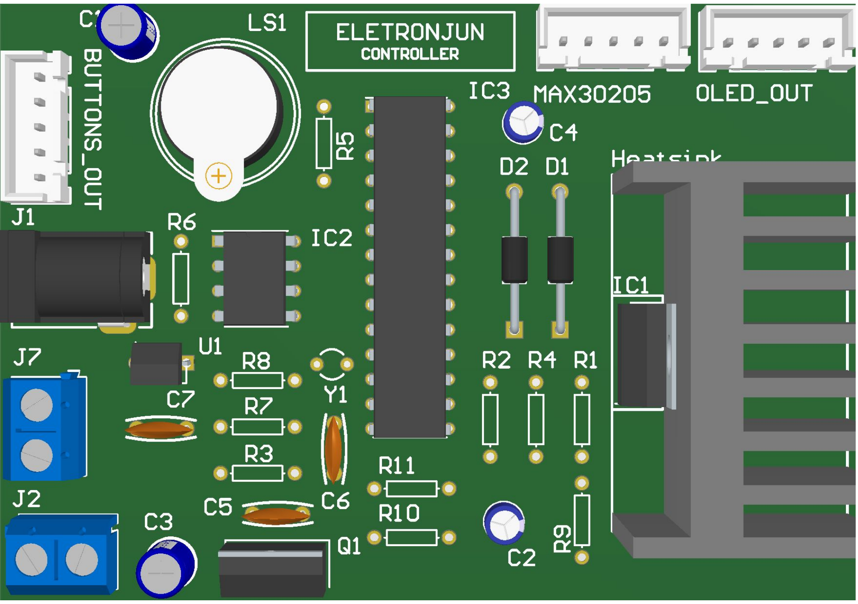
[picture p86: page 2]

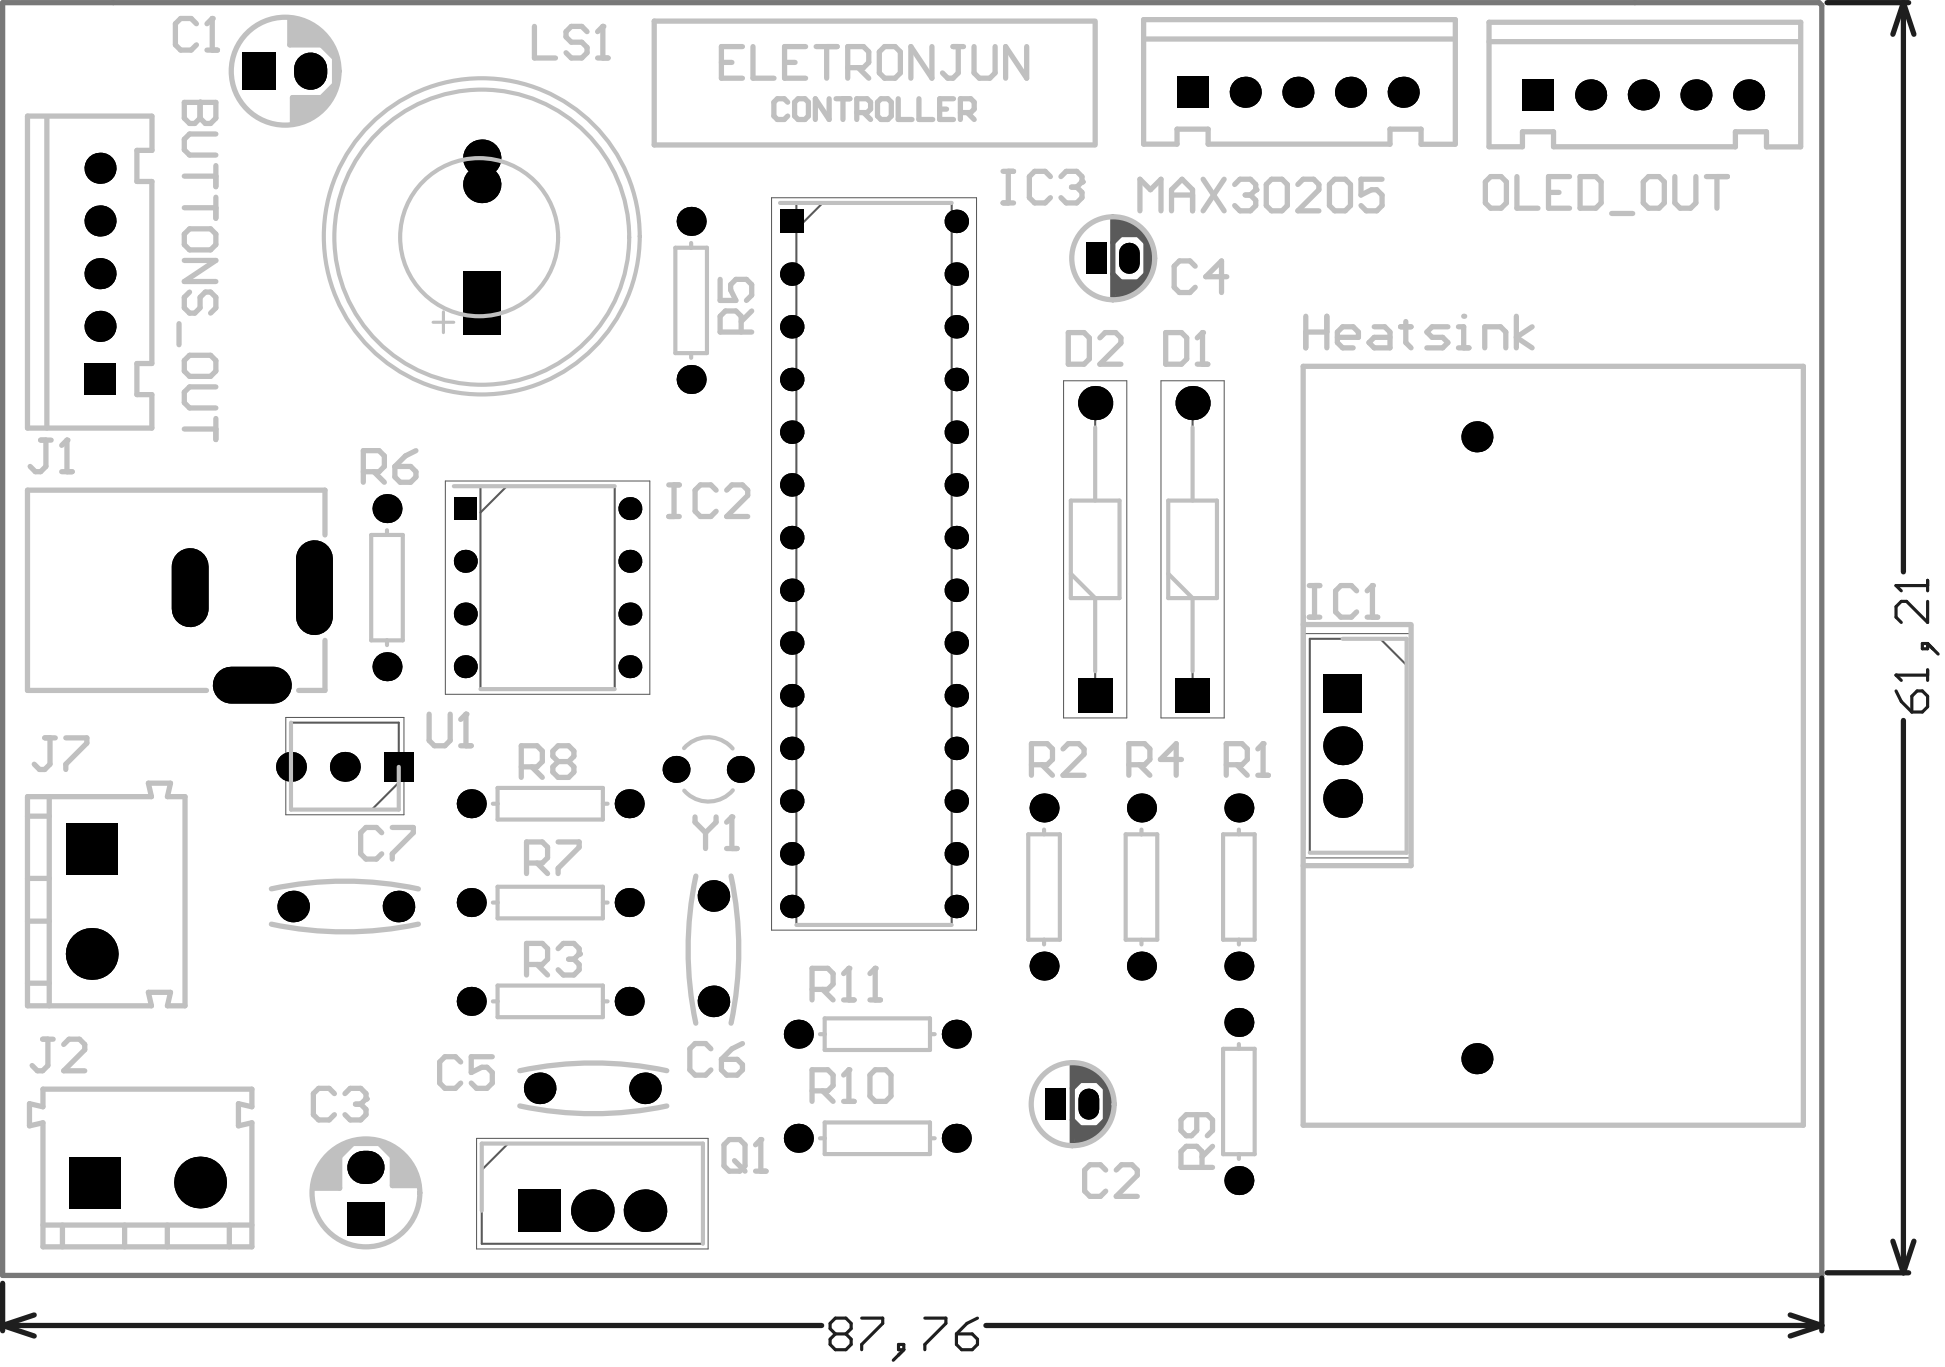
[picture p87: page 3]

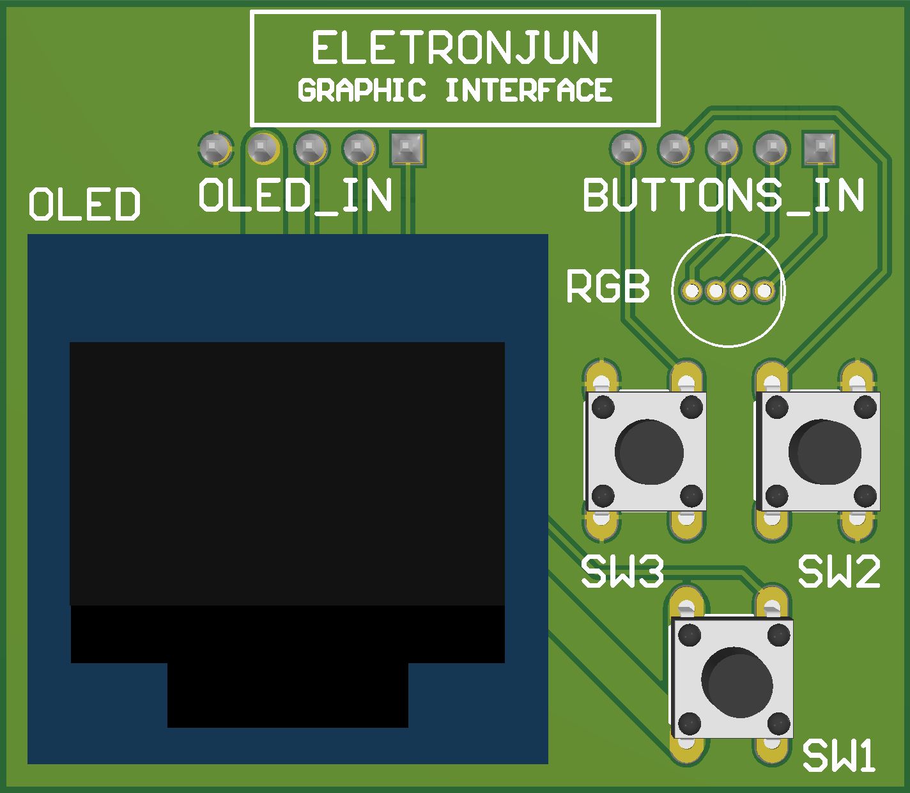
[picture p88: page 5]

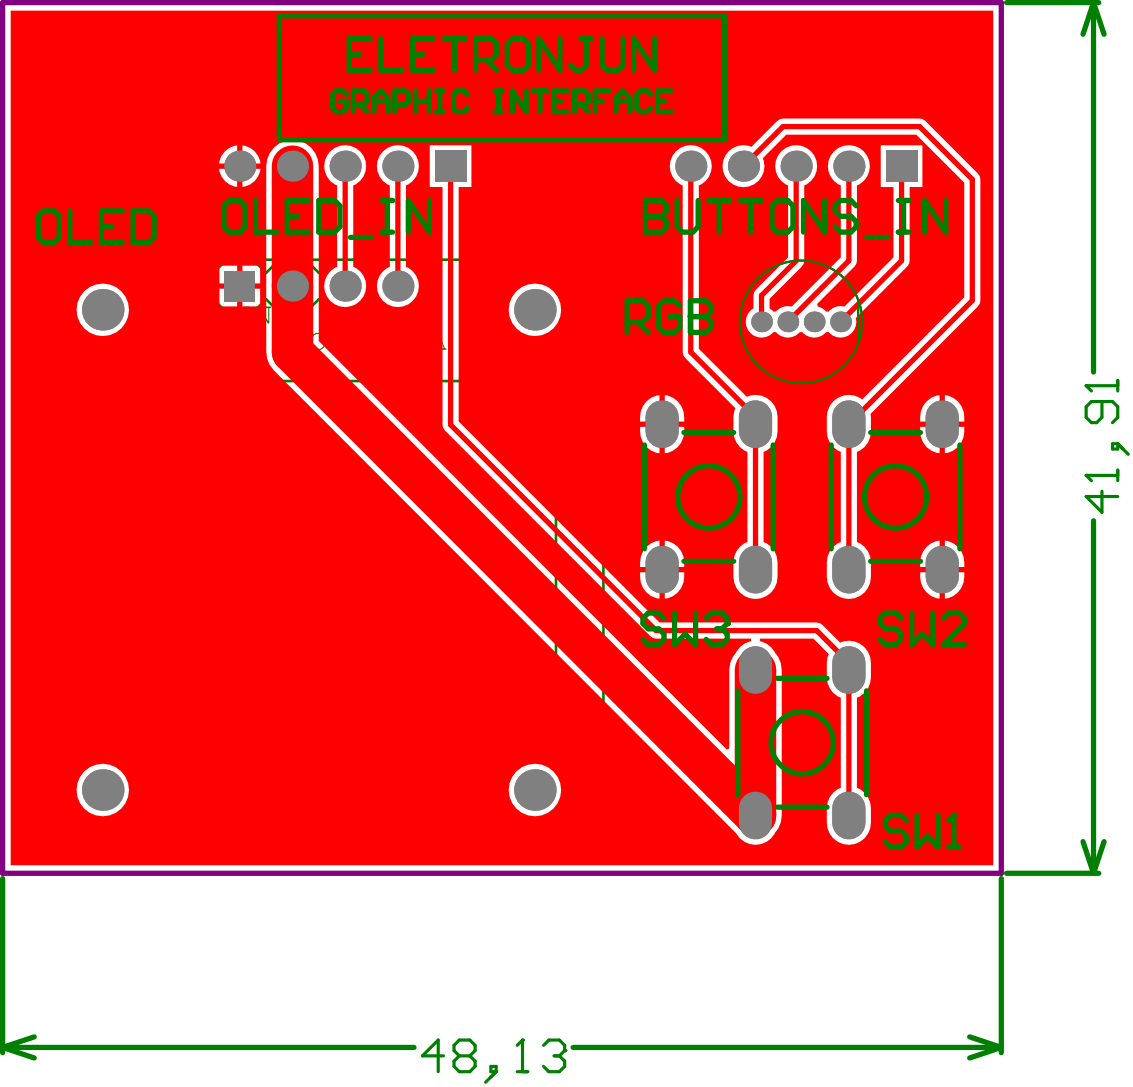
[picture p89: page 6]

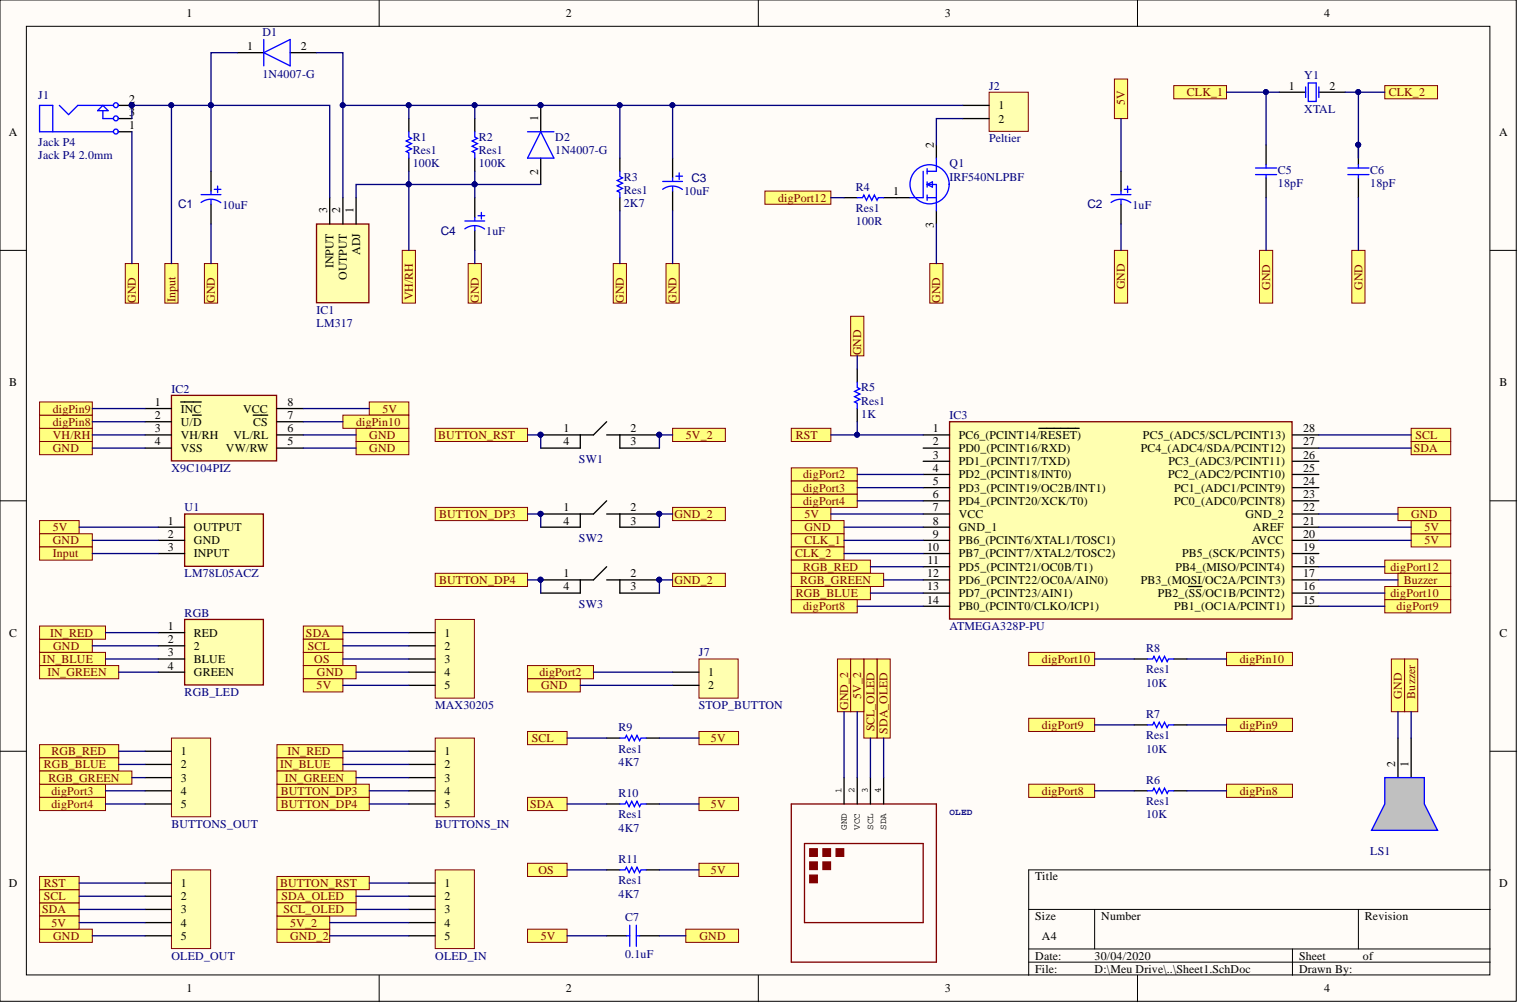
[picture p90: page 7]

GND 2 | PB6_(PCINT6/XTAL1/TOSC1) 9
INPUT 3 | | PB7_(PCINT7/XTAL2/TOSC2) 10

GND | | CLK_1 | | 5V
Input | | CLK_2

Comment | Description | Designator | Footprint | LibRef | Quantity
XH2.54-5P | 通用连接端子 | BUTTONS_IN, BUTTONS_OUT, MAX30205, OLED_IN, OLED_OUT XH2.54-5 | | XH2.54-5P | 5
Capacitor Eletrolitico | Capacitor Eletrolitico | C1, C3 | CAPACITOR ELETROLITICO 5x11x2.54mm Capacitor Eletrolitico | | 2
Capacitor Eletrolitico | Capacitor Eletrolitico | C2, C4 | CAPACITOR ELETROLITICO 4x5x1.6mm Capacitor Eletrolitico | | 2
Capacitor Ceramico | Capacitor PTH | C5, C6, C7 | Capacitor Ceramico | Capacitor Ceramico | 3
1N4007-G | Diode | D1, D2 | DIOAD1410W90L470D235 1N4007-G | | 2
LM317 | Integrated Circuit | IC1 | TO254P467X1016X1971-3P LM317 | | 1
X9C104PIZ | Integrated Circuit | IC2 | DIP794W51P254L952H533Q8N X9C104PIZ | | 1
ATMEGA328P-PU | Integrated Circuit | IC3 | DIP794W53P254L3467H457Q28N ATMEGA328P-PU | | 1
Jack P4 | Conector Femêa Jack P4J1 | | CONECTOR_JACK_P4 | Jack P4 | 1
Peltier | 通用接线端子 | J2 | KF301-5.08-2P | 接线端子-2P | 1
STOP_BUTTON | 通用接线端子 | J7 | KF301-5.08-2P | 接线端子-2P | 1
BUZZER | DC Buzzer | LS1 | Buzzer | BUZZER | 1
128x64 Dot Matrix OLED Module based on SSD1306 chipVariant with I2C interfaceMore details available here:http://www.instructables.com/id/Monochrome-096-i2c-OLED-display-with-arduino-SSD13/SSD1306 datasheet:https://cdn-shop.adafruit.com/datasheets/SSD1306.pdfClick here to find device on ebay.comNote: There are two variants: I2C and SPI. Search for the proper version. OLED | | | DISPLAY-OLED-128X64-I2C DISPLAY-OLED-128X64-I2C | | 1
IRF540NLPBF | MOSFET (N-Channel) | Q1 | TO254P483X1016X1501-3P IRF540NLPBF | | 1
Res1 | Resistor | R1, R2, R3, R4, R5, R6, R7, R8, R9, R10, R11 AXIAL-0.3 | | Res1 | 11
RGB_LED | Diode | RGB | KNIGHTBRIGHT-1.27PITCH-4PIN L-154A4SURKQBDZGW | | 1
Chave Tact | Chave Tact | SW1, SW2, SW3 | Chave TACT | Chave Tact | 3
LM78L05ACZ | Undefined or Miscellaneous U1 | | TO260P419X476X877-3PLM78L05ACZ | | 1
XTAL | Crystal Oscillator | Y1 | R38 | XTAL | 1
