matgomes21/percepcao-termica/Hardware/SCHEMATIC/Schematic -Altium.pdf

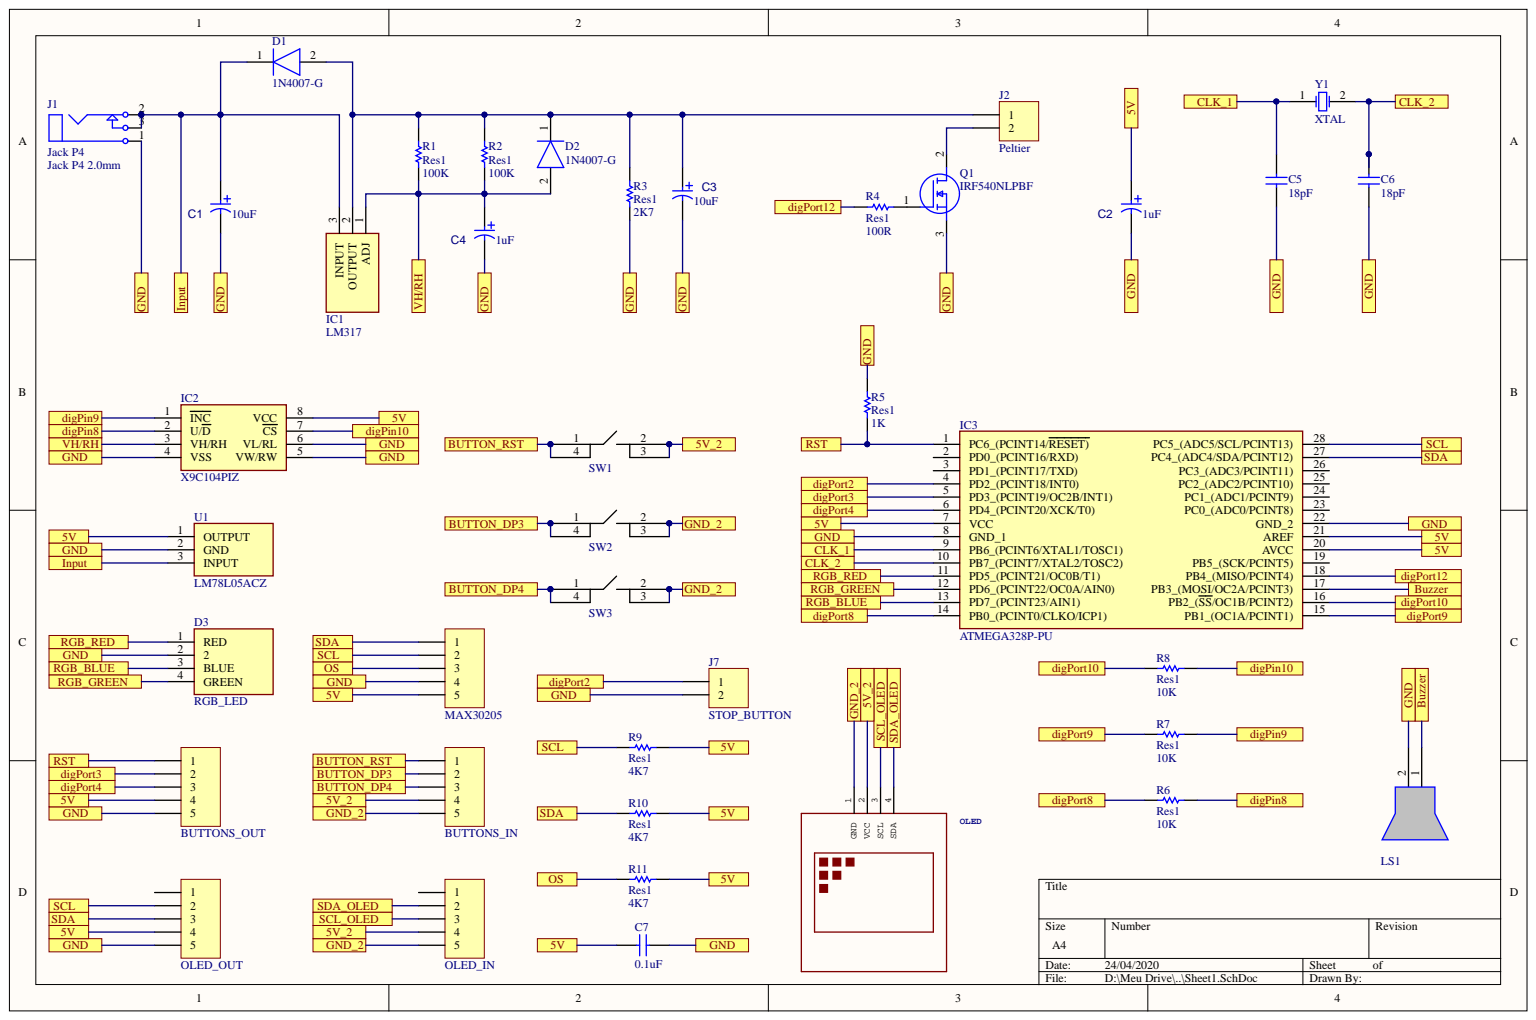
[picture p91: page 1]
