matgomes21/percepcao-termica/Hardware/SCHEMATIC/Schematic -EasyEDA.pdf

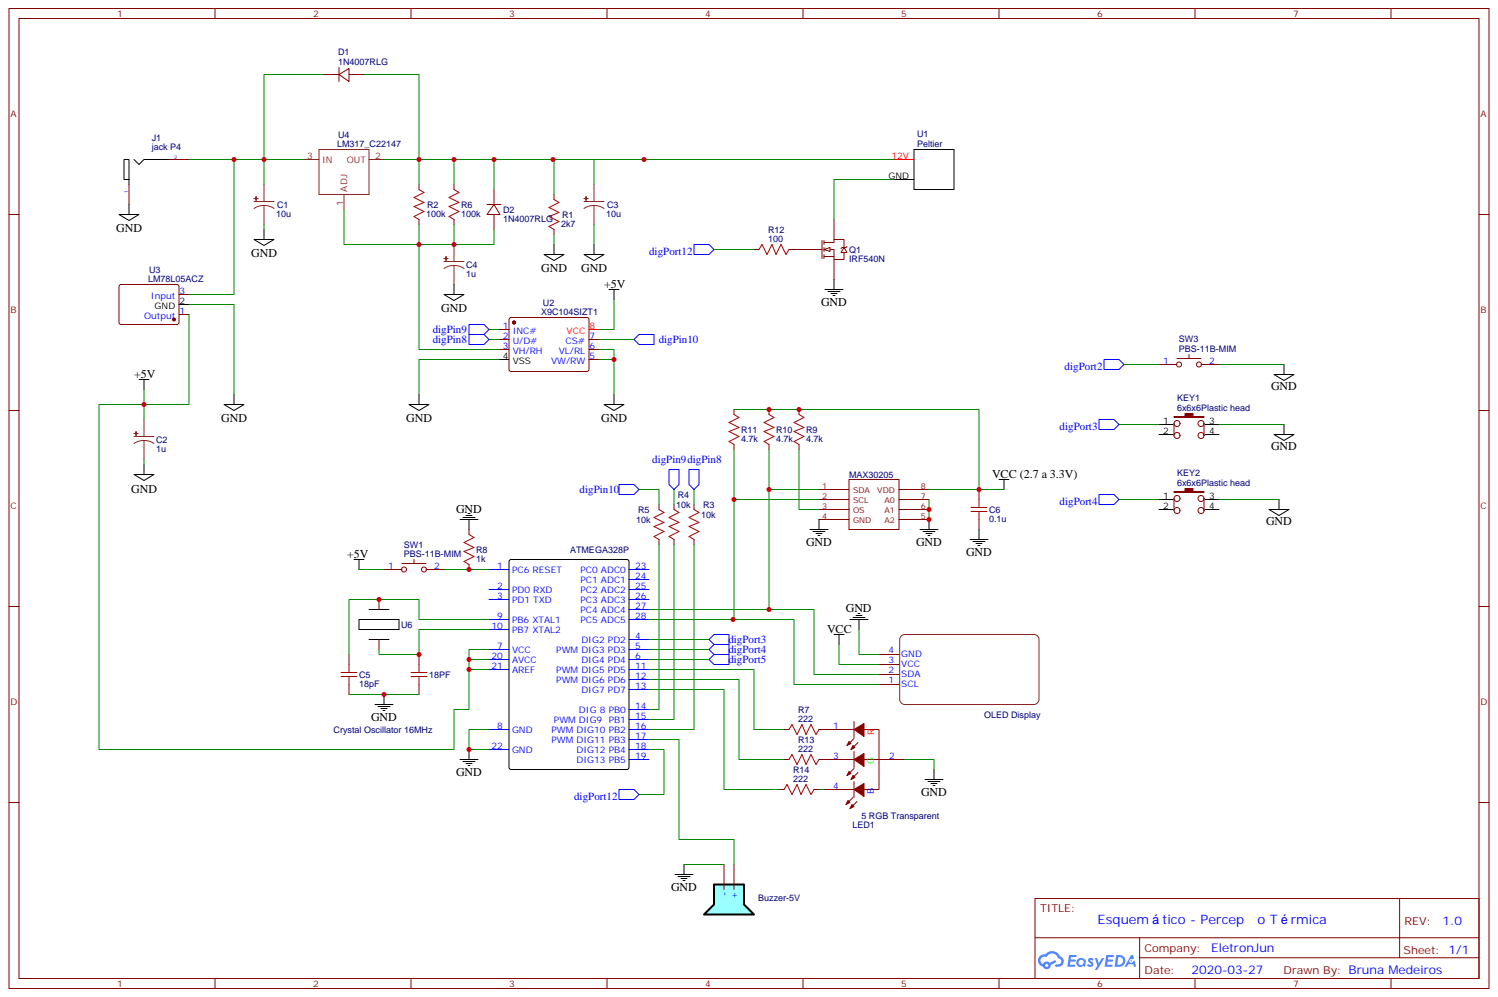
[picture p92: page 1]

Drawn By: Bruna Medeiros
