matgomes21/percepcao-termica/Software/System/main/main.ino

// Including libraries
#include "U8glib.h"
#include <Wire.h>
#include "Protocentral_MAX30205.h"
#include <x9c10x.h>
#include <Buzzer.h>
#include <PushButton.h>
#include <LedRGB.h>

// Defining pins
#define btnTeste 2
#define btnControl1 3
#define btnControl2 4
#define pin3RGB 5 // Red pin
#define pin1RGB 6 // Green pin
#define pin2RGB 7 // Blue pin
#define UD 8
#define INC 9
#define CS 10
#define buzzer 11

// Creating objects
U8GLIB_SSD1306_128X64 u8g(U8G_I2C_OPT_NONE);
MAX30205 tempSensor;
x9c10x pot(CS, INC, UD);
Buzzer buz(buzzer);
PushButton btnT(btnTeste);
PushButton btnC1(btnControl1);
PushButton btnC2(btnControl2);
LedRGB rgb(pin1RGB, pin2RGB, pin3RGB);

// Creating variables
boolean a = LOW,
        b = true,
        savepressed = true;
int menu = 1;
float temperatura,
      c = 0,
      t1 = 0,
      t2 = 0,
      t3 = 0,
      temp_limiar = 0;

unsigned long previousMillis = 0;
const long interval = 2000;

// Collects and updates the temperature of the sensor max30205
void update_max()
{
  unsigned long currentMillis = millis();
  if (currentMillis - previousMillis >= interval)
  {
    temperatura = tempSensor.getTemperature();
    previousMillis = currentMillis;
  }
}

void stopPrint(int count)
{
  switch (count)
  {
    case 0:
      t1 = temperatura;
      Serial.print("T1: ");
      Serial.print(t1);
      Serial.println("'C");
      c++;
      break;
    case 1:
      t2 = temperatura;
      Serial.print("T2: ");
      Serial.print(t2);
      Serial.println("'C");
      c++;
      break;
    default:
      t3 = temperatura;
      Serial.print("T3: ");
      Serial.print(t3);
      Serial.println("'C");
      c++;
  }
}

// Struct with screen methods
typedef struct oled
{
  void systemInit()
  {
    // Turn on green light on LED
    rgb.turnOn('g');

    // Header
    u8g.setFont(u8g_font_8x13B);
    u8g.drawRBox(0, 0, 127, 16, 2);
    u8g.setColorIndex(0);
    u8g.drawStr(18, 13, "ELETRONJUN");
    u8g.setColorIndex(1);

    // Body
    u8g.drawRFrame(18, 17, 93, 46, 2);
    u8g.setFont(u8g_font_8x13); //Determina tamanho da fonte
    u8g.drawStr(28, 35, "PERCEPCAO");
    u8g.drawStr(33, 50, "TERMICA");
  };

  void menuInit()
  {
    // Turn on green light on LED
    rgb.turnOn('g');

    // Header
    u8g.setFont(u8g_font_8x13B);
    u8g.drawRBox(0, 0, 127, 16, 2);
    u8g.setColorIndex(0);
    u8g.drawStr(17, 13, "Menu Inicial");
    u8g.setColorIndex(1);

    // Body
    u8g.setFont(u8g_font_8x13); //Determina tamanho da fonte
    u8g.drawStr(5, 30, "1.Temp Corporal");
    u8g.drawStr(5, 45, "2.Iniciar Teste");
  };

  void menuTC()
  {
    update_max();
    // Turns on Blue light on led
    rgb.turnOn('b');

    // Header
    u8g.setFont(u8g_font_8x13B);
    u8g.drawRBox(0, 0, 127, 16, 2);
    u8g.setColorIndex(0);
    u8g.drawStr(14, 13, "TEMP CORPORAL");
    u8g.setColorIndex(1);

    // Body
    // Temperature Square
    u8g.drawRFrame(23, 17, 93, 46, 2);
    u8g.setFont(u8g_font_fub20);
    // Updates displayed temperature
    u8g.setPrintPos(30, 50);
    u8g.print(temperatura, 1);
    // Draw "ºC"
    u8g.drawCircle(88, 33, 3);
    u8g.drawStr(92, 50, "C");
  }

  void menuTest()
  {
    update_max();

    if (temp_limiar == 0)
    {
      // Header
      u8g.setFont(u8g_font_8x13B);
      u8g.drawRBox(0, 0, 127, 16, 2);
      u8g.setColorIndex(0);
      u8g.drawStr(14, 13, "TEMP CORPORAL");
      u8g.setColorIndex(1);

      // Body
      // Temperature Square
      u8g.drawRFrame(0, 17, 88, 46, 2);
      u8g.setFont(u8g_font_fub20);

      //Updates displayed temperature
      u8g.setPrintPos(6, 50);
      u8g.print(temperatura, 1);
      //Draw "ºC"
      u8g.drawCircle(62, 33, 3);
      u8g.drawStr(66, 50, "C");

      if (t1 != 0)
      {
        // Header t1
        u8g.drawRFrame(87, 16, 40, 15, 2);
        u8g.setFont(u8g_font_6x12);
        // Updates on display value of t1
        u8g.setPrintPos(92, 26);
        u8g.print(t1, 1);
        u8g.drawCircle(117, 19, 1);
        u8g.drawStr(119, 26, "C");
        u8g.setColorIndex(1);
      }

      if (t2 != 0)
      {
        // Header t2
        u8g.drawRFrame(87, 31, 40, 15, 2);
        u8g.setFont(u8g_font_6x12);
        // Updates on display value of t2
        u8g.setPrintPos(92, 42);
        u8g.print(t2, 1);
        u8g.drawCircle(117, 35, 1);
        u8g.drawStr(119, 42, "C");
        u8g.setColorIndex(1);
      }
      if (t3 != 0)
      {
        // Header t3
        u8g.drawRFrame(87, 46, 40, 15, 2);
        u8g.setFont(u8g_font_6x12);
        // Updates on display value of t3
        u8g.setPrintPos(92, 56);
        u8g.print(t3, 1);
        u8g.drawCircle(117, 48, 1);
        u8g.drawStr(119, 56, "C");
        u8g.setColorIndex(1);
      }
    }
    if (temp_limiar != 0)
    {
      // Header
      u8g.setFont(u8g_font_8x13B);
      u8g.drawRBox(0, 0, 127, 16, 2);
      u8g.setColorIndex(0);
      u8g.drawStr(17, 13, "TEMP LIMIAR");
      u8g.setColorIndex(1);

      // Body
      // Temperature Square
      u8g.drawRFrame(23, 17, 93, 46, 2);
      u8g.setFont(u8g_font_fub20);
      // Updates displayed temperature
      u8g.setPrintPos(30, 50);
      u8g.print(temp_limiar, 1);
      // Draw "ºC"
      u8g.drawCircle(88, 33, 3);
      u8g.drawStr(92, 50, "C");
      while (btnT.isPressed()) {
        t1 = 0;
        t2 = 0;
        t3 = 0;
        temp_limiar = 0;
        loop();
      }

    }
  }

} Screen;

Screen screen;

// Executes the threshold test of the collected temperatures
void testLimiar()
{
  // Set button
  btnT.interrupt();

  if (btnT.isPressed())
  {
    if (c != 3)
    {
      buz.beep(500);
      int counter = 0;
      bool y = true;
      boolean flag = LOW;

      if (flag == LOW)
      {
        rgb.turnOn('r');
        while (y)
        {
          rgb.turnOn('r');
          pot.upOnce(1, 500);
          updateTest();

          if (btnT.isPressed())
          {
            y = false;
            stopPrint(c);
          }
          counter++;
        }
      }
      flag = !flag;

      if (flag == HIGH)
      {
        // Turn on blue light
        buz.beep(500);
        rgb.turnOn('b');
        for (int i = 1; i <= counter; i++)
        {
          updateTest();
          pot.downOnce(1, 500);
        }
      }
    }

    if (c == 3)
    {
      updateTest();
      delay(3000);
      temp_limiar = (t1 + t2 + t3) / 3;
      c = 0;
    }
  }
  rgb.turnOn('w');
}

// Executes the screens transitions
void changeMenu()
{
  if (menu == 1)
  {
    if (btnC1.pressed() && savepressed) //btnC2 (pin4) go to menu = 2
    {
      menu = 2;
      savepressed = !savepressed;
      delay(200);
    }
  }
  if (btnC1.pressed() && !savepressed)
  {
    menu = 1;
    savepressed = !savepressed;
    delay(200);
  }
  if (menu == 1)
  {
    if (btnC2.pressed() && savepressed) //btnC1 (pin3) go to menu = 3
    {
      menu = 3;
      savepressed = !savepressed;
      delay(200);
    }
  }
  if (btnC2.pressed() && !savepressed)
  {
    menu = 1;
    savepressed = !savepressed;
    delay(200);
  }
  chooseMenu();
}

void chooseMenu()
{
  switch (menu)
  {
    // Initial Menu
    case 1:
      screen.menuInit();
      break;

    // Actual Temperature Menu
    case 2:
      screen.menuTC();
      break;

    // Testing Menu
    case 3:
      screen.menuTest();
      testLimiar();
      break;
  }
}

void setup()
{
  // Initialization of comunication
  Serial.begin(9600);
  tempSensor.begin();
  Wire.begin();

  // Set Pot Digital
  pot.set(0, 100);

  //Apresentation Screen 
  u8g.firstPage();
  do
  {
    screen.systemInit();
  } while (u8g.nextPage());

  delay(2000);
}

void updateTest() {
  u8g.firstPage();
  do
  {
    screen.menuTest();
  } while (u8g.nextPage());
}

void loop()
{
  // Upadate Screens
  u8g.firstPage();
  do
  {
    changeMenu();
  } while (u8g.nextPage());

  delay(50);
}
