matgomes21/percepcao-termica/(commit log)

2020-01-13 Adicionei codigo para o display OLED
2020-01-13 Adicionei codigo para a interface grafica
2020-01-16 Adicionou logica com botoes para os menus
2020-01-23 Funcionalidade de voltar na interface gráfica implementada
2020-01-23 Temperatura corporal atual finalizada
2020-01-23 Foi implementado a função com o botão acenador no teste de medição
2020-01-30 Integração do display com led e buzzer
    [menu.ino]
2020-02-06 LEDs arrumados
2020-02-13 Mudança de sensor, TC funcionado
2020-02-13 Correção de bug no iniciar teste
    [menu.ino]
2020-02-20 Apresentação para o cliente
2020-04-14 Atualização de 14/04
2020-04-17 Atualização 16/04
    [BOM_Percepção_Térmica.csv]
2020-04-17 Atualização 17/04
    [BOM_Percepção_Térmica.csv]
2020-04-24 24 April update
    [BOM_Percepção_Térmica.csv]
2020-04-24 PCB update
2020-05-19 Starting CAD
2020-06-18 Home screen bug resolved
    [main.ino]
